alexisvieiro/ProyectoFinal/README.md

# Proyecto Final
  -Hardware y Software para un Hub de SNMP con sensores de temperatura y apertura de puertas, 
  realizado en Kicad y Visual Studio Code.
  
  -APP en android para la visualización de gráficas tomadas de la API de Zabbix.
