alexisvieiro/ProyectoFinal/Informes/Grupo 3 - Monitoreo Datacenter - Fotos y Videos - Proyecto Final.pdf

# Proyecto Final

“Monitoreo SNMP”

Fotos y Videos

Pruebas con el Cable del Sensor de Temperatura: Video

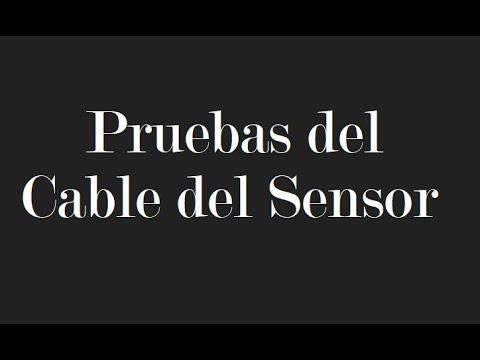
[picture p6: figure]

Vista 3D del Diseño en Proceso

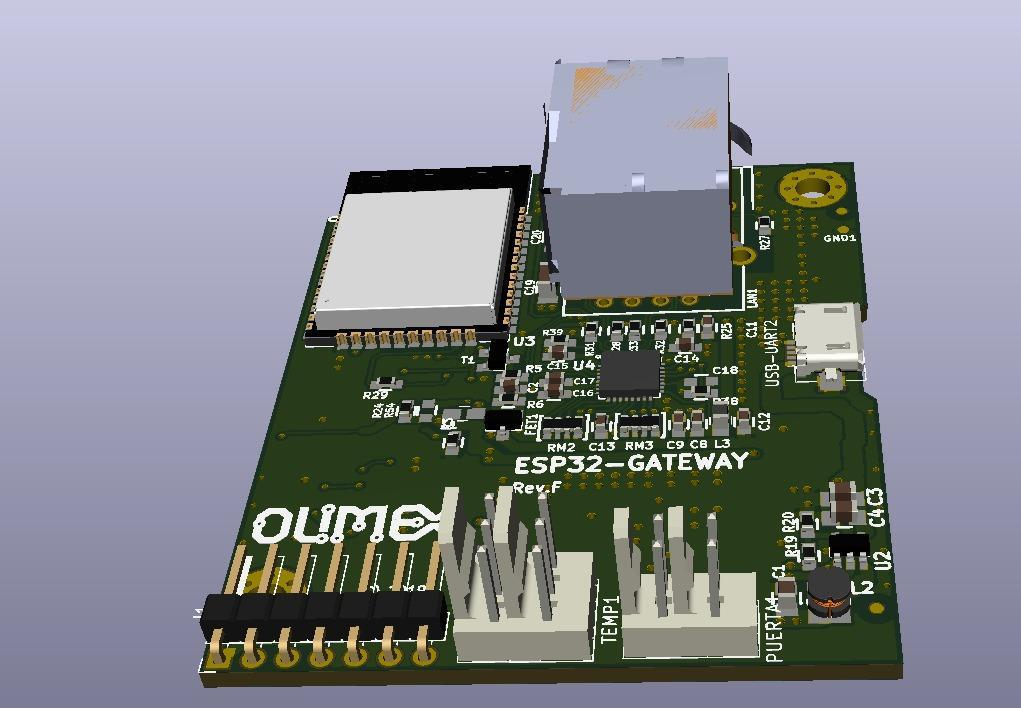
[picture p7: figure]

Vista 3D del Diseño Terminado

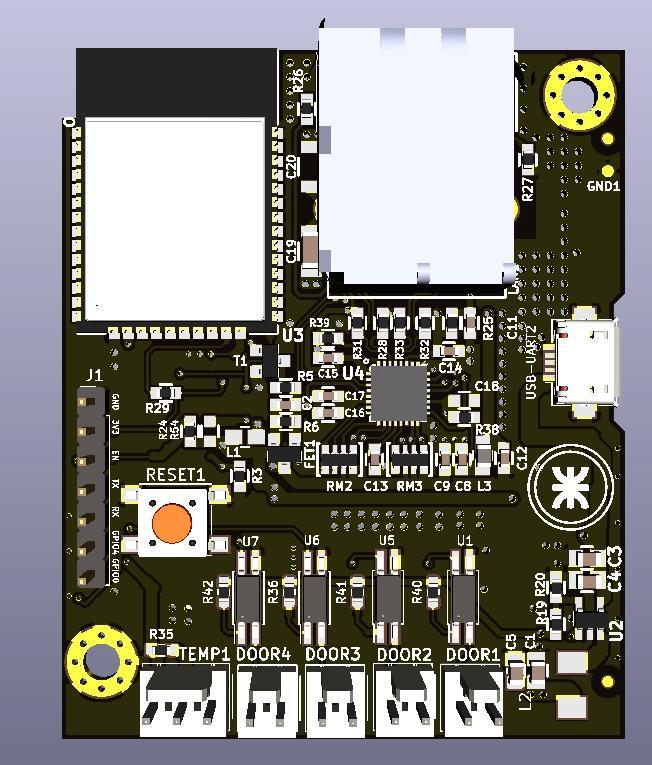
[picture p8: figure]

Llegaron las placas

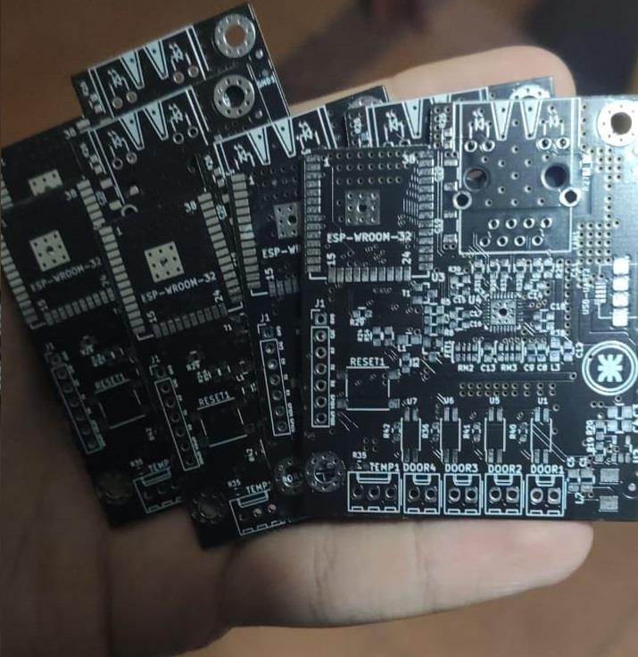
[picture p9: figure]

Placa en Proceso de Soldado

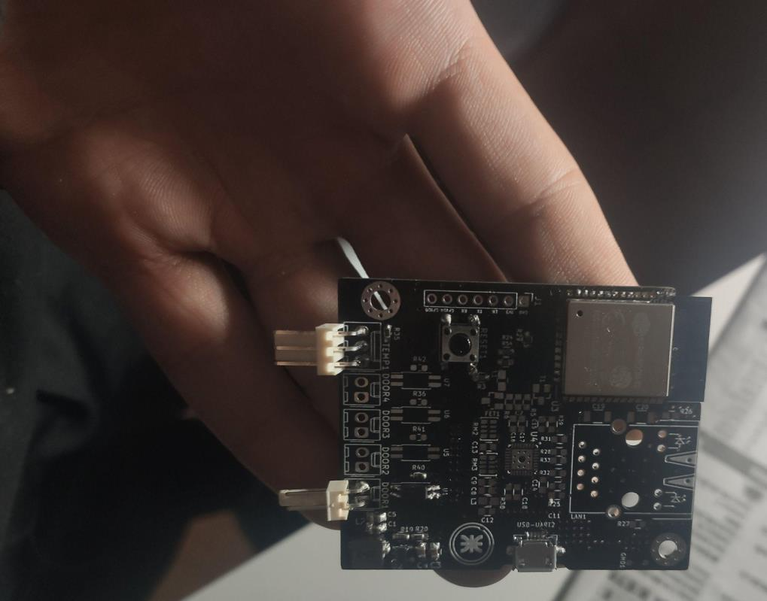
[picture p10: figure]

Primeras Pruebas

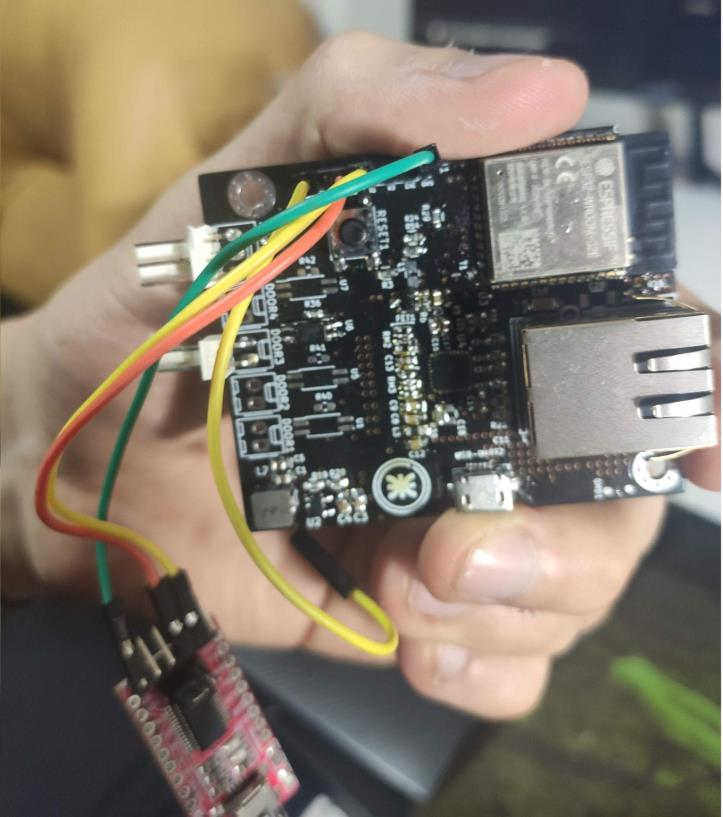
[picture p11: figure]

Primeras Pruebas SNMP: Video

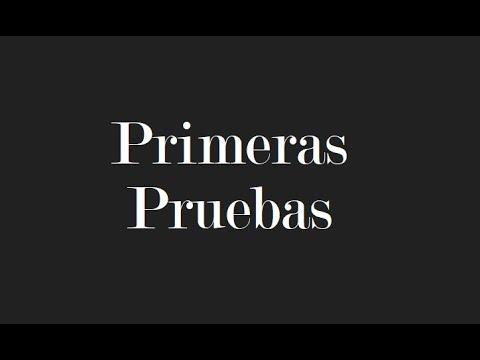
[picture p12: figure]

Placa Soldada Presentada en Carcasa

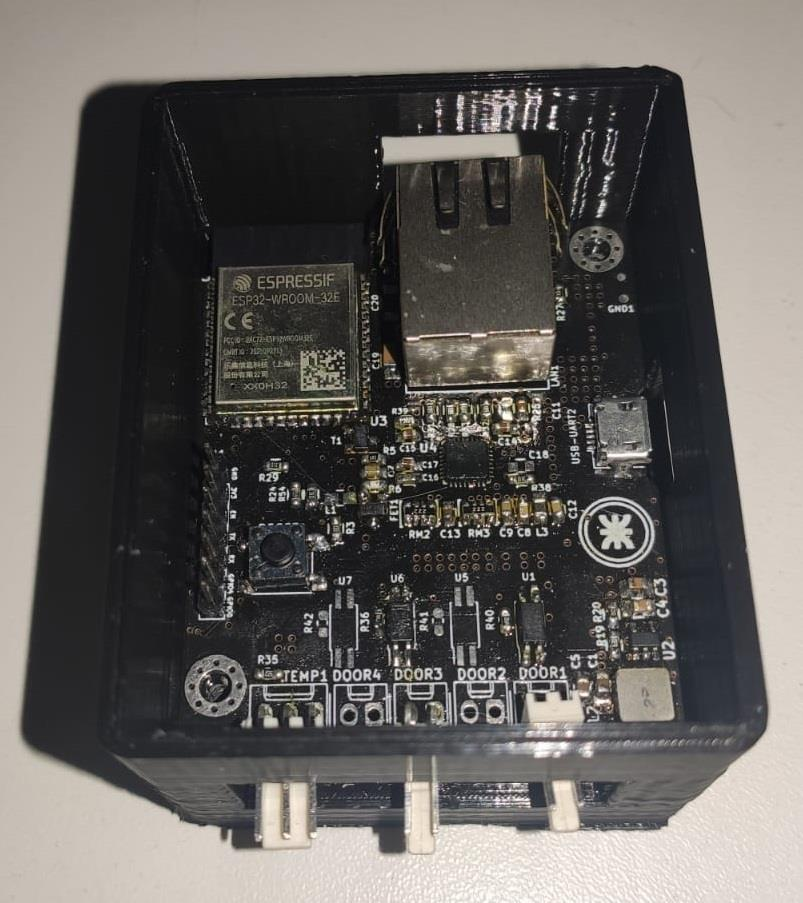
[picture p13: figure]

Placa Dentro de la Carcasa para Racks

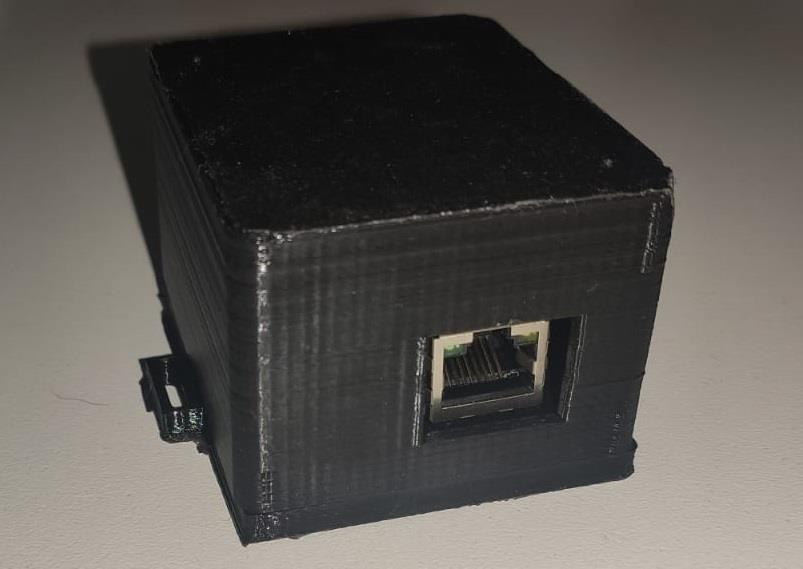
[picture p14: figure]

Pruebas Finales: Video

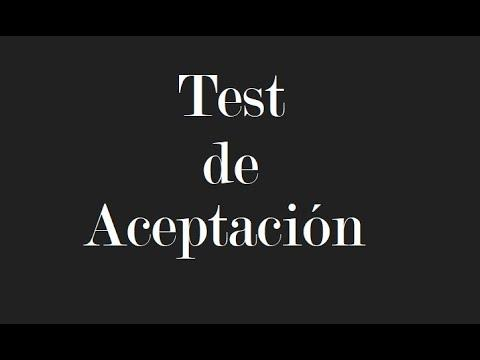
[picture p15: figure]

Aplicación Android

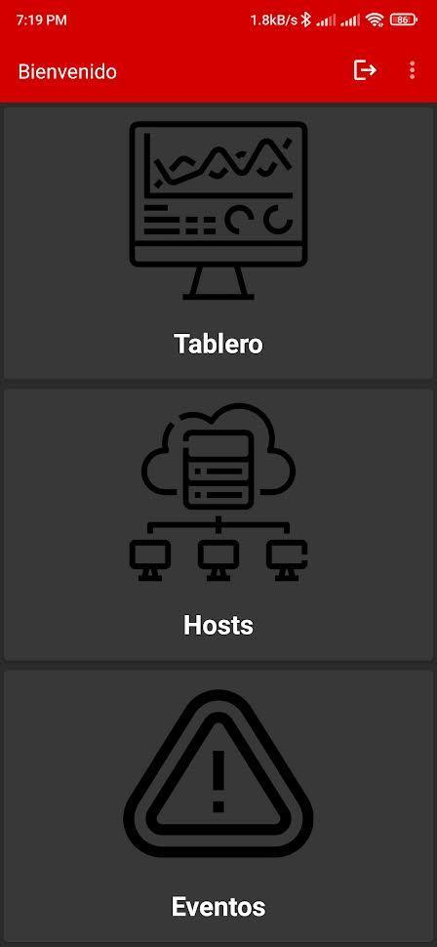
[picture p16: figure]

Gráfico de Aplicación Android en Horizontal

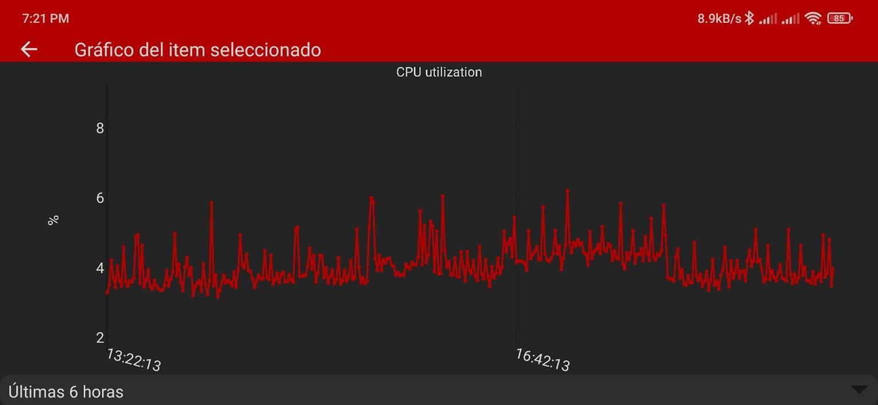
[picture p17: figure]

Zabbix Web visualizando Temperatura del Concentrador

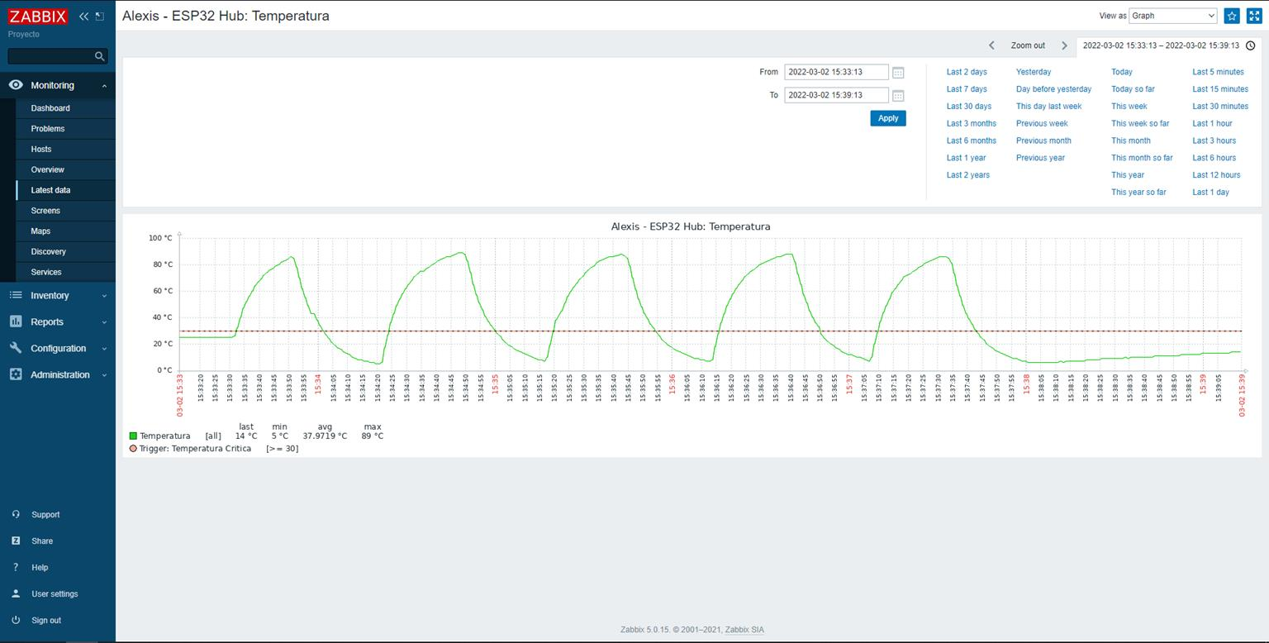
[picture p18: figure]
