alexisvieiro/ProyectoFinal/ConcentradorSNMP/Hardware/Carcasa-CarcasaTapa de la Carcasa.stl

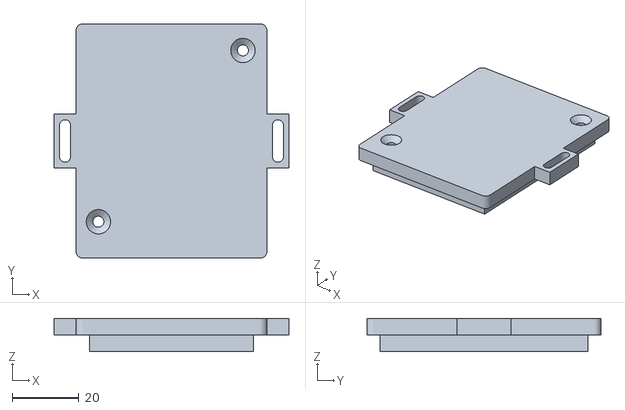
[picture p59: CAD file, 2022-03-20]
ConcentradorSNMP/Hardware/Carcasa-CarcasaTapa de la Carcasa.stl
70.2 x 70.0 x 10.0
