alexisvieiro/ProyectoFinal/ConcentradorSNMP/Hardware/3d/2pin-molex.stp

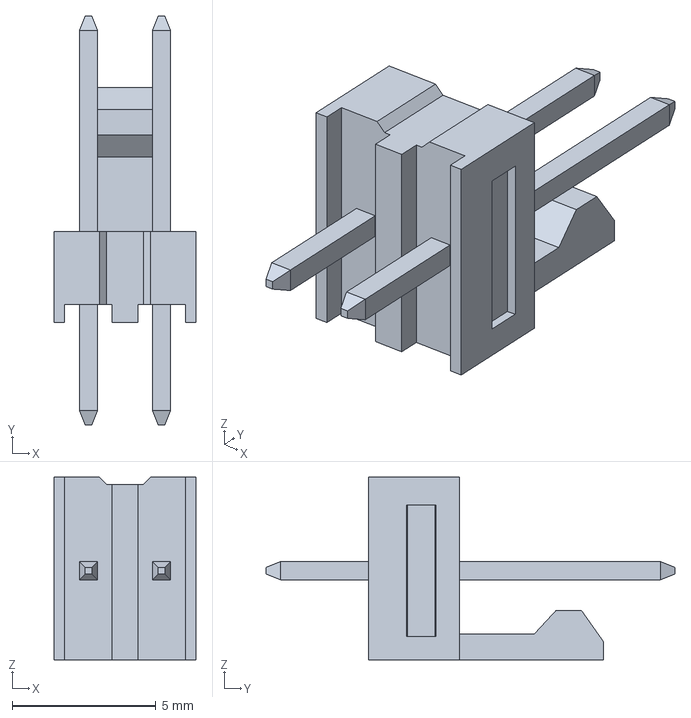
[picture p60: CAD file, 2021-08-22]
ConcentradorSNMP/Hardware/3d/2pin-molex.stp
4.93 x 14.2 x 6.35 mm
