alexisvieiro/ProyectoFinal/ConcentradorSNMP/Hardware/Carcasa-CarcasaBase de la Carcasa.stl

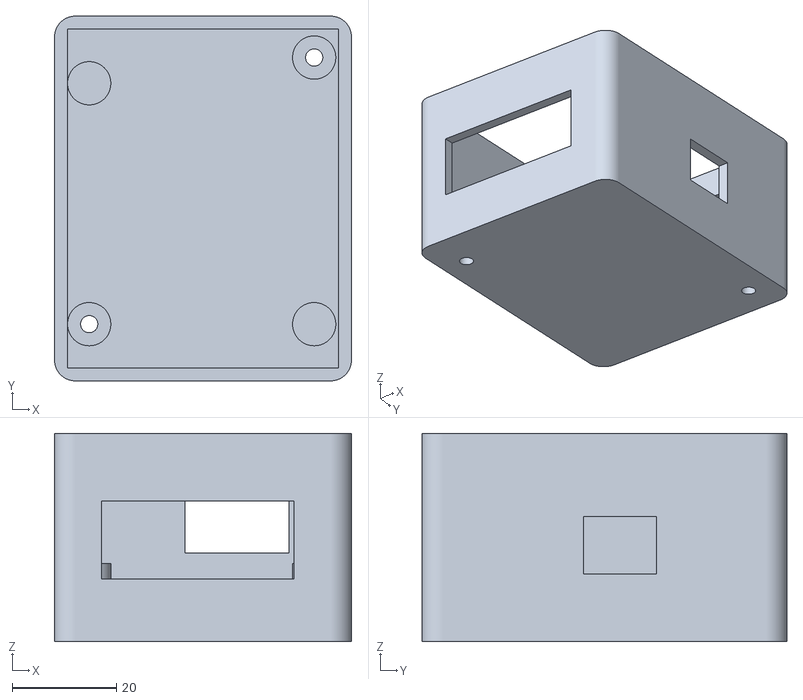
[picture p61: CAD file, 2022-03-20]
ConcentradorSNMP/Hardware/Carcasa-CarcasaBase de la Carcasa.stl
57.0 x 70.0 x 40.0
