alexisvieiro/ProyectoFinal/ConcentradorSNMP/Hardware/3d/SOT-23.step

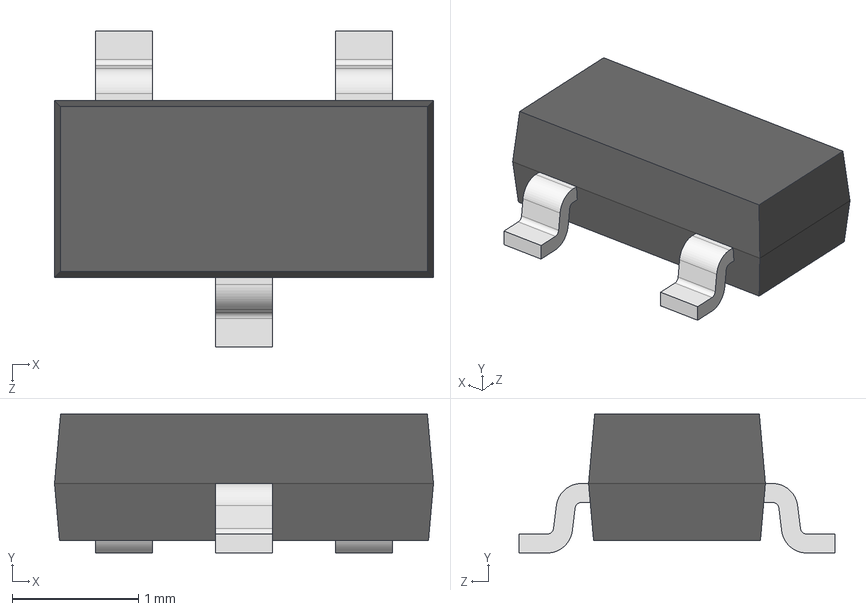
[picture p63: CAD file, 2021-07-10]
ConcentradorSNMP/Hardware/3d/SOT-23.step
3.00 x 1.10 x 2.50 mm
