alexisvieiro/ProyectoFinal/ConcentradorSNMP/Hardware/3d/SOD123.step

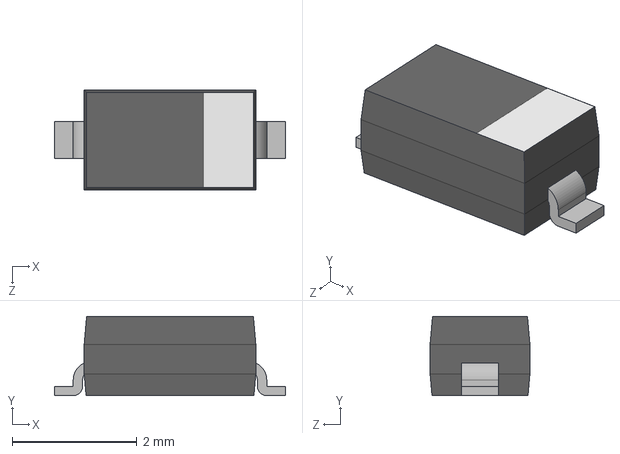
[picture p64: CAD file, 2021-07-10]
ConcentradorSNMP/Hardware/3d/SOD123.step
3.70 x 1.27 x 1.60 mm
