alexisvieiro/ProyectoFinal/ConcentradorSNMP/Hardware/3d/QFN32_5x5.step

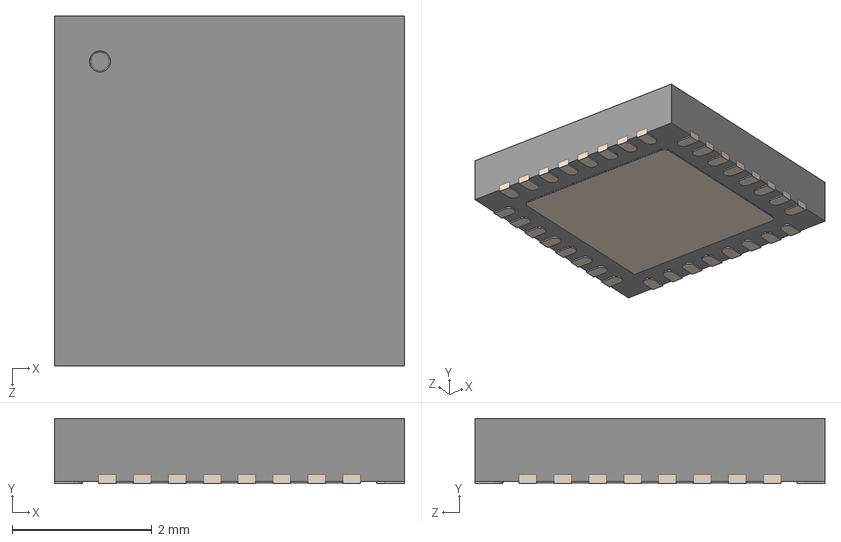
[picture p65: CAD file, 2021-07-10]
ConcentradorSNMP/Hardware/3d/QFN32_5x5.step
5.00 x 0.93 x 5.00 mm
