alexisvieiro/ProyectoFinal/ConcentradorSNMP/Hardware/3d/DO-214AC_SMA.step

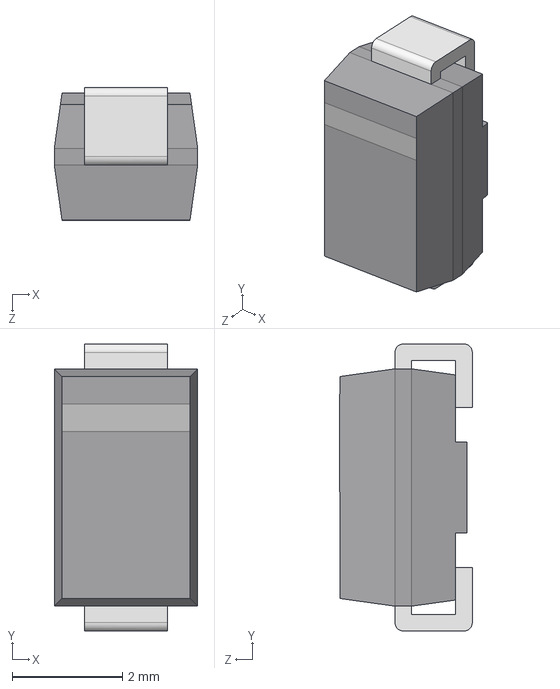
[picture p66: CAD file, 2021-07-10]
ConcentradorSNMP/Hardware/3d/DO-214AC_SMA.step
2.60 x 5.20 x 2.40 mm
