alexisvieiro/ProyectoFinal/ConcentradorSNMP/Hardware/3d/ESP32-WROOM-32D-56544.STEP

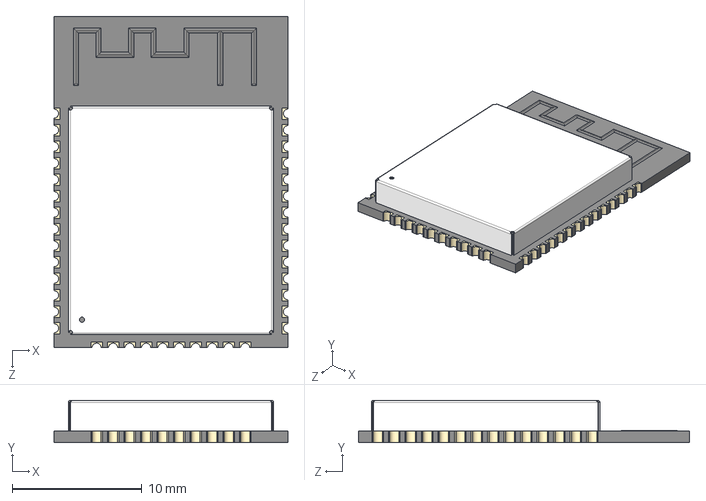
[picture p67: CAD file, 2021-07-10]
ConcentradorSNMP/Hardware/3d/ESP32-WROOM-32D-56544.STEP
18.0 x 3.25 x 25.5 mm
