alexisvieiro/ProyectoFinal/ConcentradorSNMP/Hardware/3d/esp-wroom-32.step

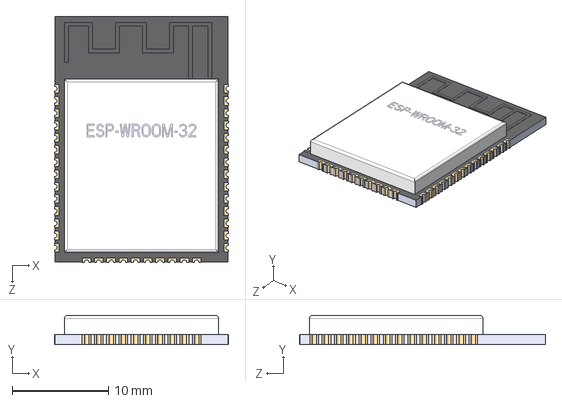
[picture p68: CAD file, 2021-07-10]
ConcentradorSNMP/Hardware/3d/esp-wroom-32.step
18.1 x 3.04 x 25.5 mm
