alexisvieiro/ProyectoFinal/ConcentradorSNMP/Hardware/3d/User_Library-Crystal_HC49_US-SM.step

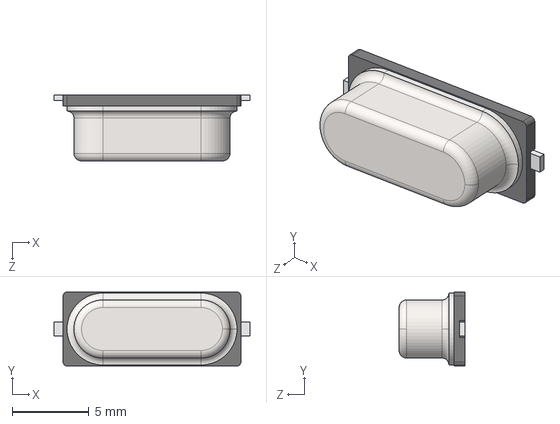
[picture p69: CAD file, 2021-07-10]
ConcentradorSNMP/Hardware/3d/User_Library-Crystal_HC49_US-SM.step
12.8 x 4.83 x 4.30 mm
