alexisvieiro/ProyectoFinal/ConcentradorSNMP/Hardware/3d/usb_micro_4p.stp

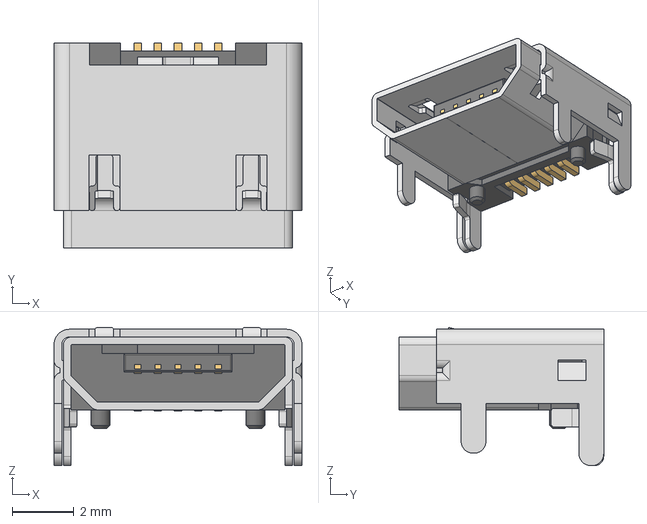
[picture p70: CAD file, 2021-07-10]
ConcentradorSNMP/Hardware/3d/usb_micro_4p.stp
8.00 x 6.60 x 4.46 mm
