alexisvieiro/ProyectoFinal/ConcentradorSNMP/Hardware/3d/BAT54.step

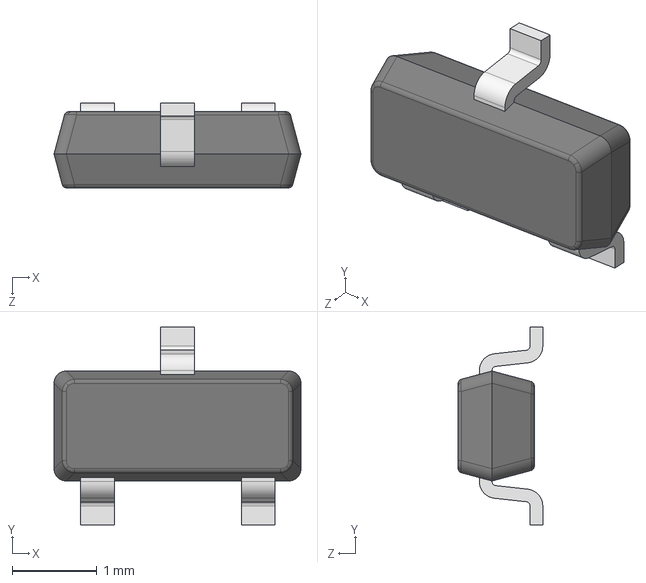
[picture p71: CAD file, 2021-07-10]
ConcentradorSNMP/Hardware/3d/BAT54.step
2.92 x 2.34 x 1.00 mm
