alexisvieiro/ProyectoFinal/ConcentradorSNMP/Hardware/3d/DO-214AA_SMB.step

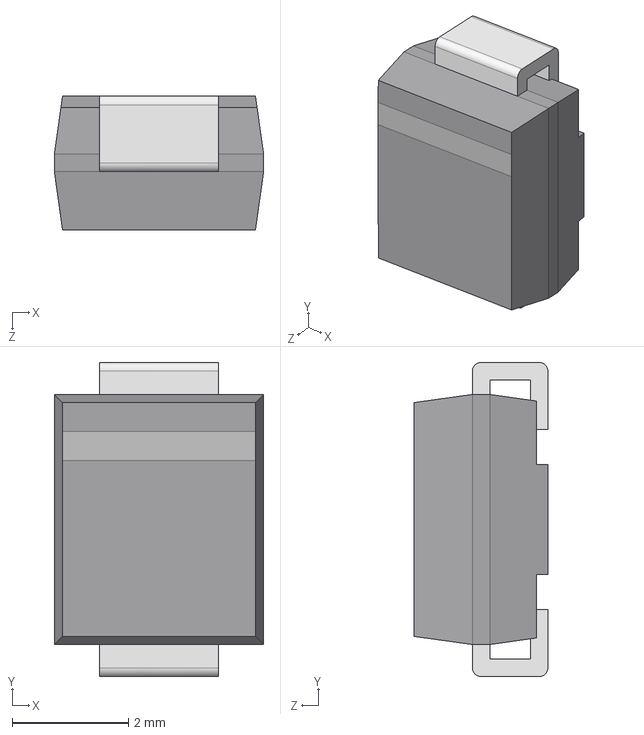
[picture p72: CAD file, 2021-07-10]
ConcentradorSNMP/Hardware/3d/DO-214AA_SMB.step
3.60 x 5.40 x 2.30 mm
