alexisvieiro/ProyectoFinal/ConcentradorSNMP/Hardware/3d/CD32_inductor.step

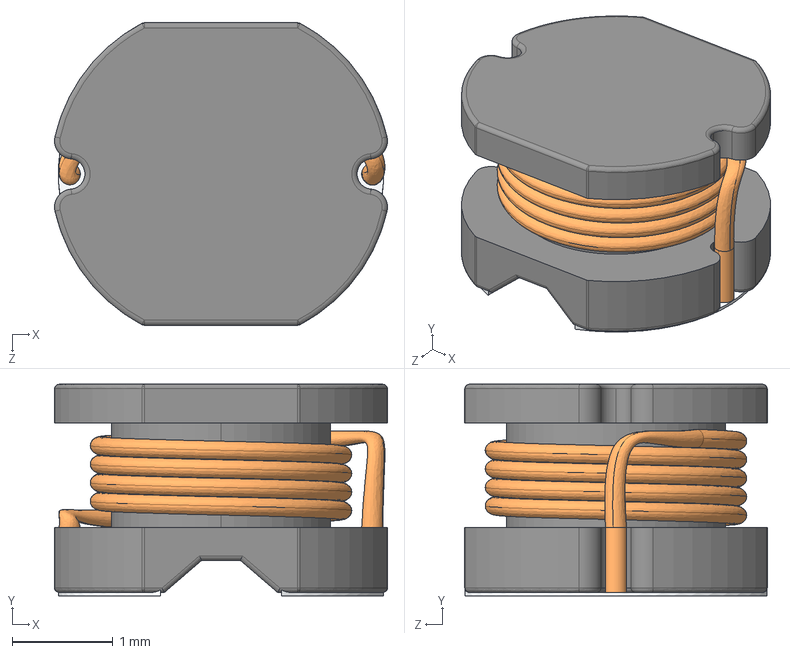
[picture p73: CAD file, 2021-07-10]
ConcentradorSNMP/Hardware/3d/CD32_inductor.step
3.30 x 2.10 x 3.00 mm
