alexisvieiro/ProyectoFinal/ConcentradorSNMP/Hardware/3d/10104110-0001LF.stp

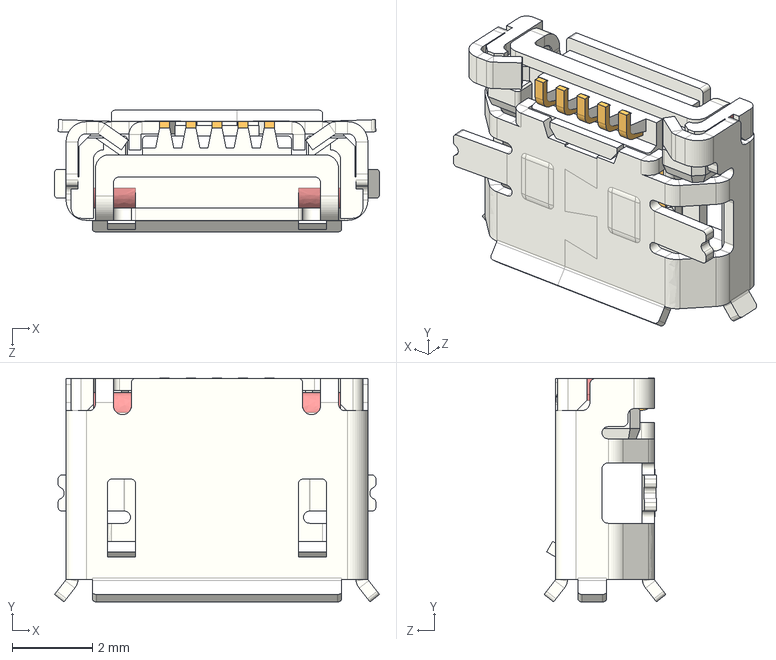
[picture p74: CAD file, 2021-08-22]
ConcentradorSNMP/Hardware/3d/10104110-0001LF.stp
8.08 x 5.56 x 3.03 mm
