alexisvieiro/ProyectoFinal/ConcentradorSNMP/Hardware/3d/434121043836 (rev1).stp

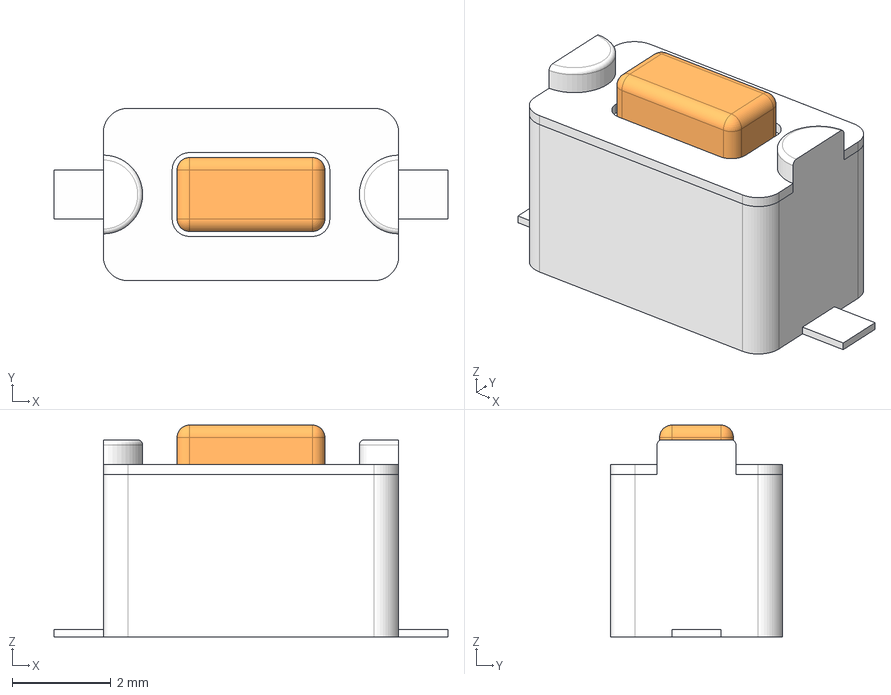
[picture p75: CAD file, 2021-07-10]
ConcentradorSNMP/Hardware/3d/434121043836 (rev1).stp
8.00 x 3.50 x 4.30 mm
Frame
Cover
pins x 2
