alexisvieiro/ProyectoFinal/(list of files, cad)

Other CAD files:
ConcentradorSNMP/Hardware/Carcasa.FCStd
ConcentradorSNMP/Hardware/3d/5040771891.stp
