alexisvieiro/ProyectoFinal/ConcentradorSNMP/Hardware/Gerbers Propios/HUB-SNMP-F_SilkS.pdf

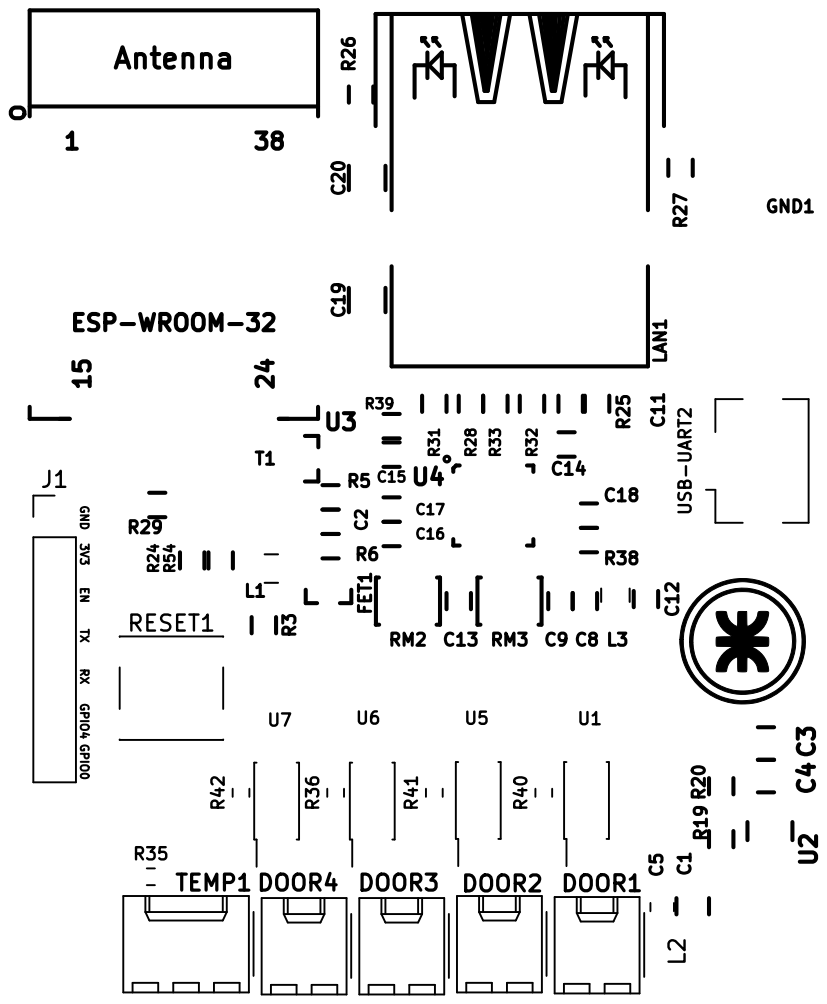
[picture p85: page 1]

GPIO0 GPIO4 RX TX EN 3V3 GND R42 DOOR4
