alexisvieiro/ProyectoFinal/ConcentradorSNMP/Hardware/HUB-SNMP_Esquematico.pdf

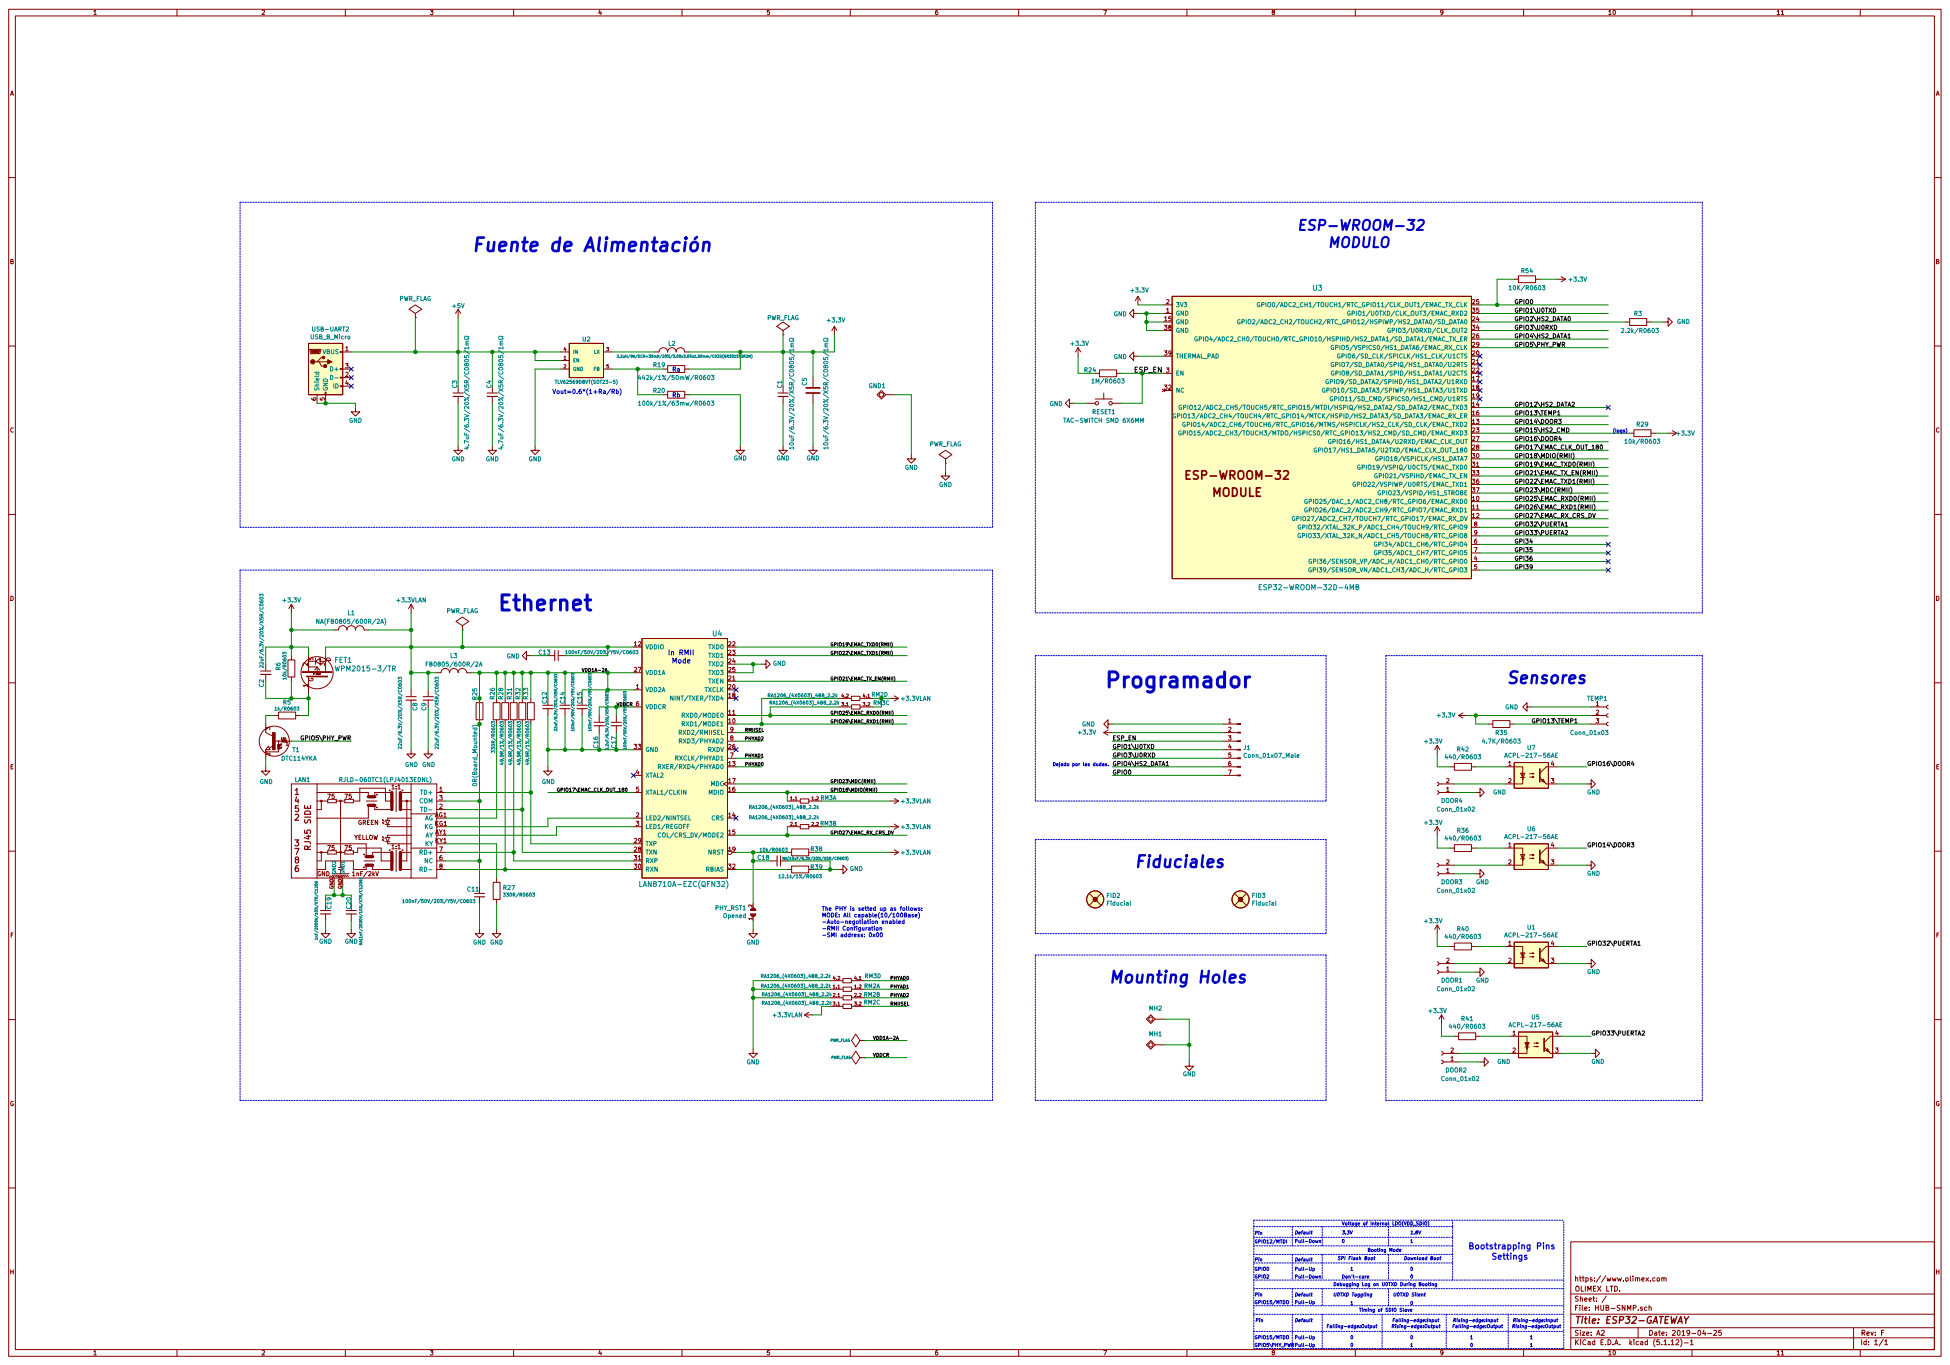
[picture p86: page 1]

0 Falling-edge:Input 1 Ethernet

Dejado por las dudas. The PHY is setted up as follows: MODE: All capable(10/100Base)

File: HUB-SNMP.sch Sheet: / OLIMEX LTD. https://www.olimex.com

0 Debugging Log on U0TXD During Booting
