alexisvieiro/ProyectoFinal/ConcentradorSNMP/Hardware/Gerbers Propios/HUB-SNMP-B_Cu.pdf

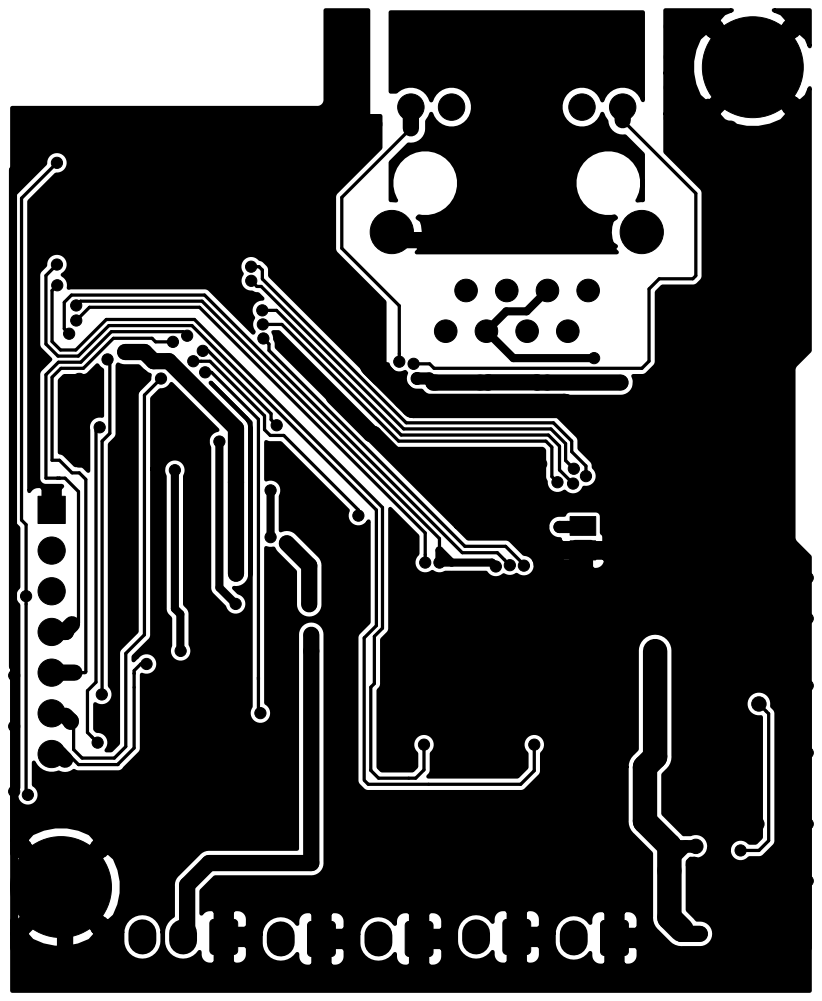
[picture p87: page 1]
