alexisvieiro/ProyectoFinal/ConcentradorSNMP/Hardware/Gerbers Propios/HUB-SNMP-B_Mask.pdf

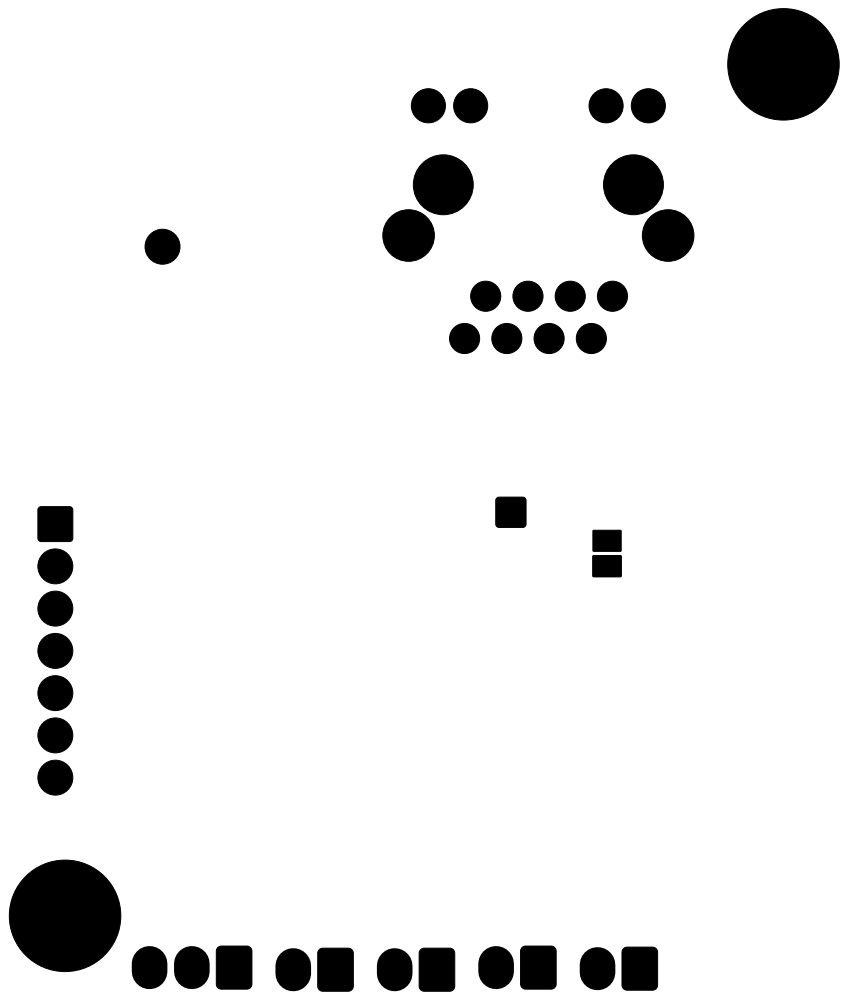
[picture p88: page 1]
