alexisvieiro/ProyectoFinal/ConcentradorSNMP/Hardware/Gerbers Propios/HUB-SNMP-B_SilkS.pdf

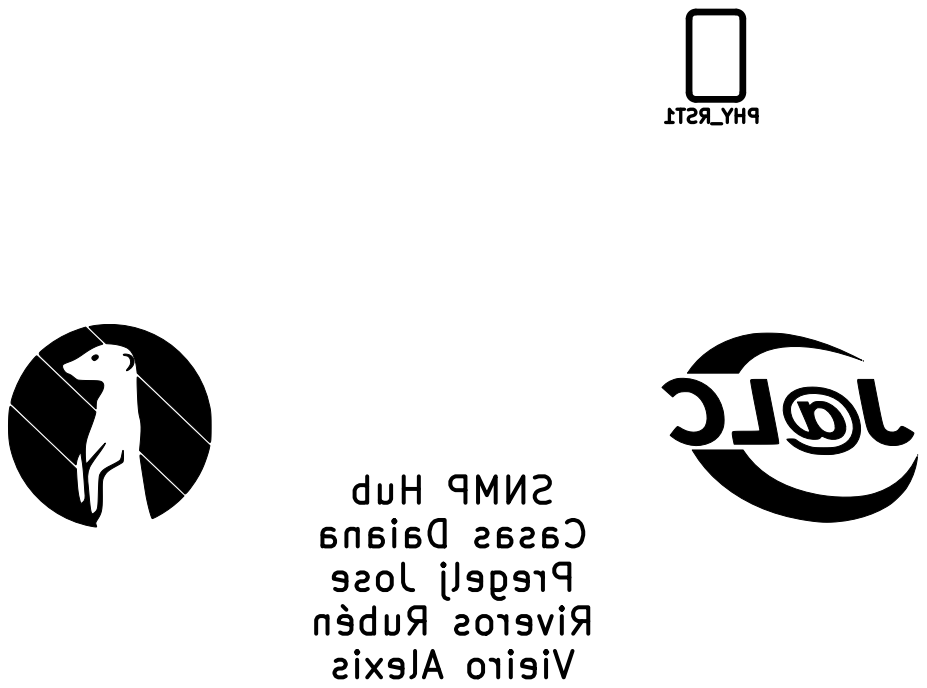
[picture p89: page 1]

SNMP Hub Casas Daiana Pregelj Jose Riveros Rubén Vieiro Alexis
