alexisvieiro/ProyectoFinal/ConcentradorSNMP/Hardware/Gerbers Propios/HUB-SNMP-Dwgs_User.pdf

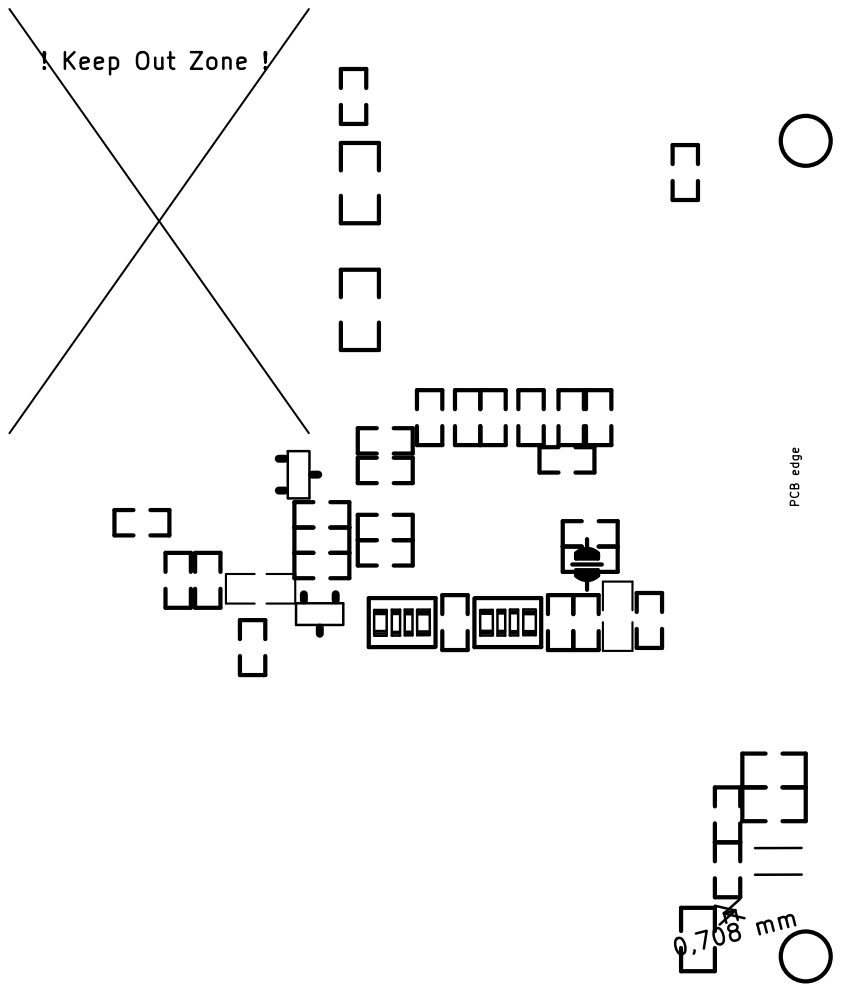
[picture p90: page 1]
