alexisvieiro/ProyectoFinal/ConcentradorSNMP/Hardware/Gerbers Propios/HUB-SNMP-F_CrtYd.pdf

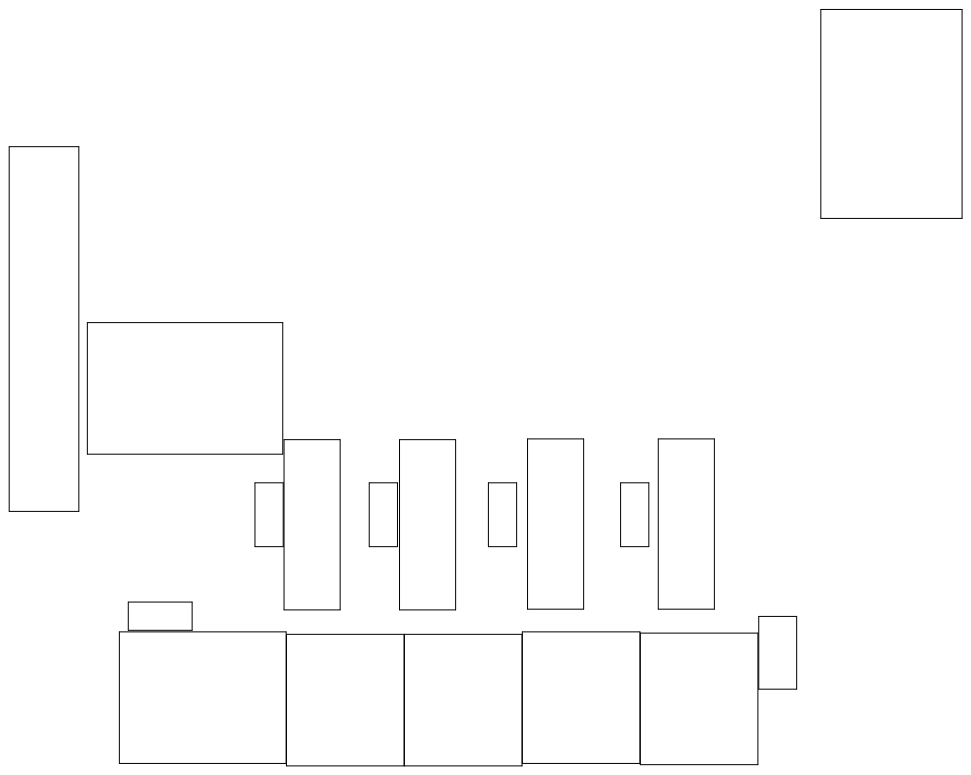
[picture p91: page 1]
