alexisvieiro/ProyectoFinal/ConcentradorSNMP/Hardware/HUB-SNMP.kicad_pcb

## KiCad design ConcentradorSNMP/Hardware/HUB-SNMP.kicad_pcb (2021-11-24)

Schematic: HUB-SNMP.sch, ESP32-GATEWAY

Parts:
C1: 10uF/6.3V/20%/X5R/C0805/1mΩ; C_0805_5MIL_DWS
C2, C8, C9, C12: 22uF/6.3V/20%/X5R/C0603; C_0603_5MIL_DWS
C3, C4: 4.7uF/6.3V/20%/X5R/C0805/1mΩ; C_0805_5MIL_DWS
C5: 10uF/6.3V/20%/X5R/C0805/1mΩ; C_0805_2012Metric_Pad1.18x1.45mm_HandSolder
C11, C13, C14, C15, C17: 100nF/50V/20%/Y5V/C0603; C_0603_5MIL_DWS
C16: 2.2uF/6.3V/10%/X5R/C0603; C_0603_5MIL_DWS
C18: NA(10uF/6.3V/20%/X5R/C0603); C_0603_5MIL_DWS
C19: 1nF/2000V/10%/X7R/C1206; C_1206_5MIL_DWS_ISO
C20: NA(1nF/2000V/10%/X7R/C1206); C_1206_5MIL_DWS_ISO
DOOR1, DOOR2, DOOR3, DOOR4: Conn_01x02; Molex_KK-254_AE-6410-02A_1x02_P2.54mm_Vertical
FET1: WPM2015-3/TR; SOT23
FID2, FID3: Fiducial; Fiducial1x3
GND1: TESTPAD; TESTPAD_40-ROUND
J1: Conn_01x07_Male; PinHeader_1x07_P2.54mm_Vertical
L1: NA(FB0805/600R/2A); L_0805_5MIL_DWS
L2: 2.2uH/9A/DCR=35mR/20%/3.00x3.00x1.50mm/CD32(NR301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; SMD_0530
L3: FB0805/600R/2A; L_0805_5MIL_DWS
LAN1: RJLD-060TC1(LPJ4013EDNL); RJLBC-060TC1
MH1, MH2: Mounting_hole_Shield_3.3mm
PHY_RST1: Opened; SJ
R3: 2.2k/R0603; R_0603_5MIL_DWS
R5: 1k/R0603; R_0603_5MIL_DWS
R6, R29, R38: 10k/R0603; R_0603_5MIL_DWS
R19: 442k/1%/50mW/R0603; R_0603_5MIL_DWS
R20: 100k/1%/63mw/R0603; R_0603_5MIL_DWS
R24: 1M/R0603; R_0603_5MIL_DWS
R25: 0R(Board_Mounted); R_0603_5MIL_DWS
R26, R27: 330R/R0603; R_0603_5MIL_DWS
R28, R31, R32, R33: 49.9R/1%/R0603; R_0603_5MIL_DWS
R35: 4.7K/R0603; R_0603_1608Metric_Pad0.98x0.95mm_HandSolder
R36, R40, R41, R42: 440/R0603; R_0603_1608Metric_Pad0.98x0.95mm_HandSolder
R39: 12.1k/1%/R0603; R_0603_5MIL_DWS
R54: 10K/R0603; R_0603_5MIL_DWS
RESET1: TAC-SWITCH SMD 6X6MM; SW_SPST_PTS645
RM2, RM3: RA1206_(4X0603)_4B8_2.2k; R_MATRIX_4
T1: DTC114YKA; SOT23
TEMP1: Conn_01x03; Molex_KK-254_AE-6410-03A_1x03_P2.54mm_Vertical
U1, U5, U6, U7: ACPL-217-56AE; SO-4_4.4x2.3mm_P1.27mm
U2: TLV62569DBVT(SOT23-5); SOT-23-5
U3: ESP32-WROOM-32D-4MB; ESP-WROOM-32_MODULE
U4: LAN8710A-EZC(QFN32); QFN32_EP(33)_5.00x5.00x0.90mm_Pitch_0.50mm
USB-UART2: USB_B_Micro; USB_Micro-B_Amphenol_10104110_Horizontal

Connections:
+3.3VLAN: C8.1, C9.1, C13.1, FET1.3, L1.2, L3.1, R38.2, RM2.3.1, RM2.4.1, RM3.1.2, RM3.2.2, RM3.3.2, U4.12 (VDDIO)
+3V3: C1.1, C2.1, C5.1, FET1.2, J1.2, L1.1, L2.2, R6.1, R19.2, R24.1, R29.1, R35.2, R36.2, R40.2, R41.2, R42.2, R54.2, TEMP1.2, U3.2 (3V3)
+5V: C3.1, C4.1, U2.1 (EN), U2.4 (IN), USB-UART2.1 (VBUS)
/ESP_EN: J1.3, R24.2, RESET1.2, U3.3 (EN)
/GPI34: U3.6 (GPI34/ADC1_CH6/RTC_GPIO4)
/GPI35: U3.7 (GPI35/ADC1_CH7/RTC_GPIO5)
/GPI36: U3.4 (GPI36/SENSOR_VP/ADC_H/ADC1_CH0/RTC_GPIO0)
/GPI39: U3.5 (GPI39/SENSOR_VN/ADC1_CH3/ADC_H/RTC_GPIO3)
/GPIO0: J1.7, R54.1, U3.25 (GPIO0/ADC2_CH1/TOUCH1/RTC_GPIO11/CLK_OU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)
/GPIO1\U0TXD: J1.4, U3.35 (GPIO1/U0TXD/CLK_OUT3/EMAC_RXD2)
/GPIO2\HS2_DATA0: R3.2, U3.24 (GPIO2/ADC2_CH2/TOUCH2/RTC_GPIO12/HSPIWP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)
/GPIO3\U0RXD: J1.5, U3.34 (GPIO3/U0RXD/CLK_OUT2)
/GPIO4\HS2_DATA1: J1.6, U3.26 (GPIO4/ADC2_CH0/TOUCH0/RTC_GPIO10/HSPIHD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)
/GPIO5\PHY_PWR: T1.1 (B), U3.29 (GPIO5/VSPICS0/HS1_DATA6/EMAC_RX_CLK)
/GPIO12\HS2_DATA2: U3.14 (GPIO12/ADC2_CH5/TOUCH5/RTC_GPIO15/MTDI/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)
/GPIO13\TEMP1: R35.1, TEMP1.3, U3.16 (GPIO13/ADC2_CH4/TOUCH4/RTC_GPIO14/MTCK/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)
/GPIO14\DOOR3: U3.13 (GPIO14/ADC2_CH6/TOUCH6/RTC_GPIO16/MTMS/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), U6.4
/GPIO15\HS2_CMD: R29.2, U3.23 (GPIO15/ADC2_CH3/TOUCH3/MTDO/HSPICS0/RTC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)
/GPIO16\DOOR4: U3.27 (GPIO16/HS1_DATA4/U2RXD/EMAC_CLK_OUT), U7.4
/GPIO17\EMAC_CLK_OUT_180: U3.28 (GPIO17/HS1_DATA5/U2TXD/EMAC_CLK_OUT_180), U4.5 (XTAL1/CLKIN)
/GPIO18\MDIO(RMII): RM3.1.1, U3.30 (GPIO18/VSPICLK/HS1_DATA7), U4.16 (MDIO)
/GPIO19\EMAC_TXD0(RMII): U3.31 (GPIO19/VSPIQ/U0CTS/EMAC_TXD0), U4.22 (TXD0)
/GPIO21\EMAC_TX_EN(RMII): U3.33 (GPIO21/VSPIHD/EMAC_TX_EN), U4.21 (TXEN)
/GPIO22\EMAC_TXD1(RMII): U3.36 (GPIO22/VSPIWP/U0RTS/EMAC_TXD1), U4.23 (TXD1)
/GPIO23\MDC(RMII): U3.37 (GPIO23/VSPID/HS1_STROBE), U4.17 (MDC)
/GPIO25\EMAC_RXD0(RMII): RM3.3.1, U3.10 (GPIO25/DAC_1/ADC2_CH8/RTC_GPIO6/EMAC_RX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), U4.11 (RXD0/MODE0)
/GPIO26\EMAC_RXD1(RMII): RM2.4.2, U3.11 (GPIO26/DAC_2/ADC2_CH9/RTC_GPIO7/EMAC_RX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), U4.10 (RXD1/MODE1)
/GPIO27\EMAC_RX_CRS_DV: RM3.2.1, U3.12 (GPIO27/ADC2_CH7/TOUCH7/RTC_GPIO17/EMAC_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), U4.15 (COL/CRS_DV/MODE2)
/GPIO32\PUERTA1: U1.4, U3.8 (GPIO32/XTAL_32K_P/ADC1_CH4/TOUCH9/RTC_G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)
/GPIO33\PUERTA2: U3.9 (GPIO33/XTAL_32K_N/ADC1_CH5/TOUCH8/RTC_G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), U5.4
/PHYAD0: RM3.4.1, U4.13 (RXER/RXD4/PHYAD0)
/PHYAD1: RM2.1.2, U4.7 (RXCLK/PHYAD1)
/PHYAD2: RM2.2.2, U4.8 (RXD3/PHYAD2)
/RMIISEL: RM2.3.2, U4.9 (RXD2/RMIISEL)
/VDD1A-2A: C11.1, C12.1, C14.1, C15.1, L3.2, LAN1.3 (COM), LAN1.6 (NC), R25.1, R25.2, R26.1, R28.1, R31.1, R32.1, R33.1, U4.1 (VDD2A), U4.27 (VDD1A)
/VDDCR: C16.1, C17.1, U4.6 (VDDCR)
GND: C1.2, C3.2, C4.2, C5.2, C8.2, C9.2, C11.2, C12.2, C13.2, C14.2, C15.2, C16.2, C17.2, C18.1, C19.2, C20.2, DOOR1.1, DOOR2.1, DOOR3.1, DOOR4.1, GND1.1, J1.1, MH1.GND1, MH2.GND1, PHY_RST1.1, R3.1, R20.2, R27.2, R39.2, RESET1.1, RM2.1.1, RM2.2.1, RM3.4.2, T1.2 (E), TEMP1.1, U1.3, U2.2 (GND), U3.1 (GND), U3.15 (GND), U3.38 (GND), U3.39 (THERMAL_PAD), U4.24 (TXD2), U4.25 (TXD3), U4.33 (GND), U5.3, U6.3, U7.3, USB-UART2.5 (GND), USB-UART2.6 (Shield)
unnamed: C2.2, FET1.1, R5.1, R6.2
unnamed: C18.2, PHY_RST1.2, R38.1, U4.19 (NRST)
unnamed: C19.1, C20.1, LAN1.GND1, LAN1.GND2
unnamed: DOOR1.2, U1.2
unnamed: DOOR2.2, U5.2
unnamed: DOOR3.2, U6.2
unnamed: DOOR4.2, U7.2
unnamed: L2.1, U2.3 (LX)
unnamed: LAN1.1 (TD+), R33.2, U4.29 (TXP)
unnamed: LAN1.2 (TD-), R32.2, U4.28 (TXN)
unnamed: LAN1.7 (RD+), R31.2, U4.31 (RXP)
unnamed: LAN1.8 (RD-), R28.2, U4.30 (RXN)
unnamed: LAN1.AG1 (AG), R26.2
unnamed: LAN1.AY1 (AY), U4.3 (LED1/REGOFF)
unnamed: LAN1.KG1 (KG), U4.2 (LED2/NINTSEL)
unnamed: LAN1.KY1 (KY), R27.1
unnamed: R5.2, T1.3 (C)
unnamed: R19.1, R20.1, U2.5 (FB)
unnamed: R36.1, U6.1
unnamed: R39.1, U4.32 (RBIAS)
unnamed: R40.1, U1.1
unnamed: R41.1, U5.1
unnamed: R42.1, U7.1

Notes on the sheet:
Vout=0.6*(1+Ra/Rb)
Fuente de Alimentación
In RMII Mode
Ethernet
ESP-WROOM-32 MODULO
Bootstrapping Pins Settings
Voltage of Internal LDO(VDD_SDIO)
Pin
Default
3.3V
1.8V
Booting Mode
GPIO12/MTDI
Pull-Down
GPIO0
GPIO2
Pull-Up
SPI Flash Boot
Download Boot
Don't-care
Debugging Log on U0TXD During Booting
U0TXD Toggling
U0TXD Silent
GPIO15/MTDO
Timing of SDIO Slave
Falling-edge:Output
Falling-edge:Input
Rising-edge:Output
Rising-edge:Input
GPIO5\PHY_PWR
Sensores
The PHY is setted up as follows: MODE: All capable(10/100Base) -Auto-negotiation enabled -RMII Configuration -SMI address: 0x00
Programador
Mounting Holes
Fiduciales
(logs)
GPIO5\PHY_PWR:
MTDO/GPIO15:
GPIO4:
GPIO2:
GPIO0:
MTDI/GPIO12:
Internal Bootstrapping Resistors
Dejado por las dudas.

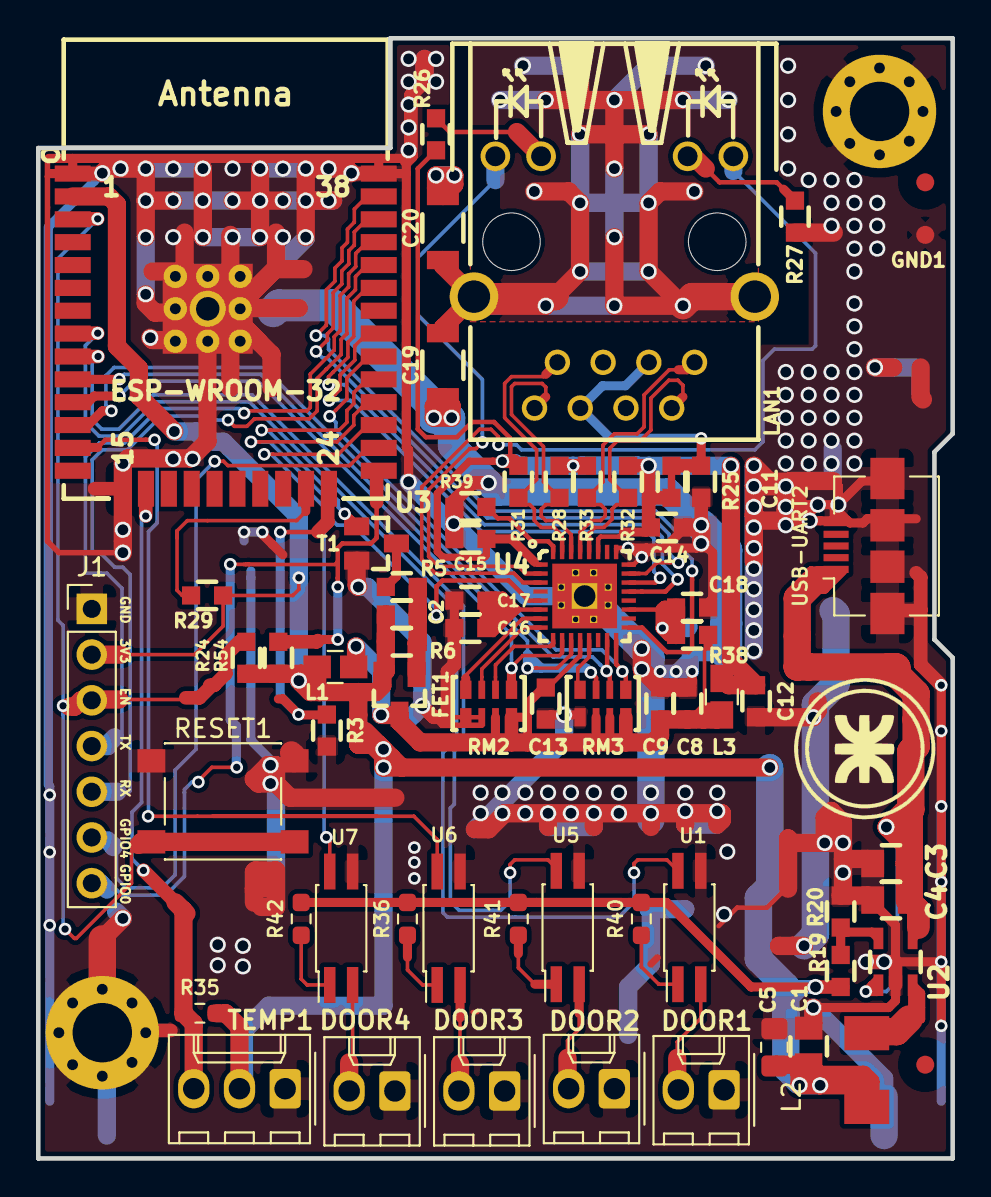
[picture p96: board HUB-SNMP.kicad_pcb from above]

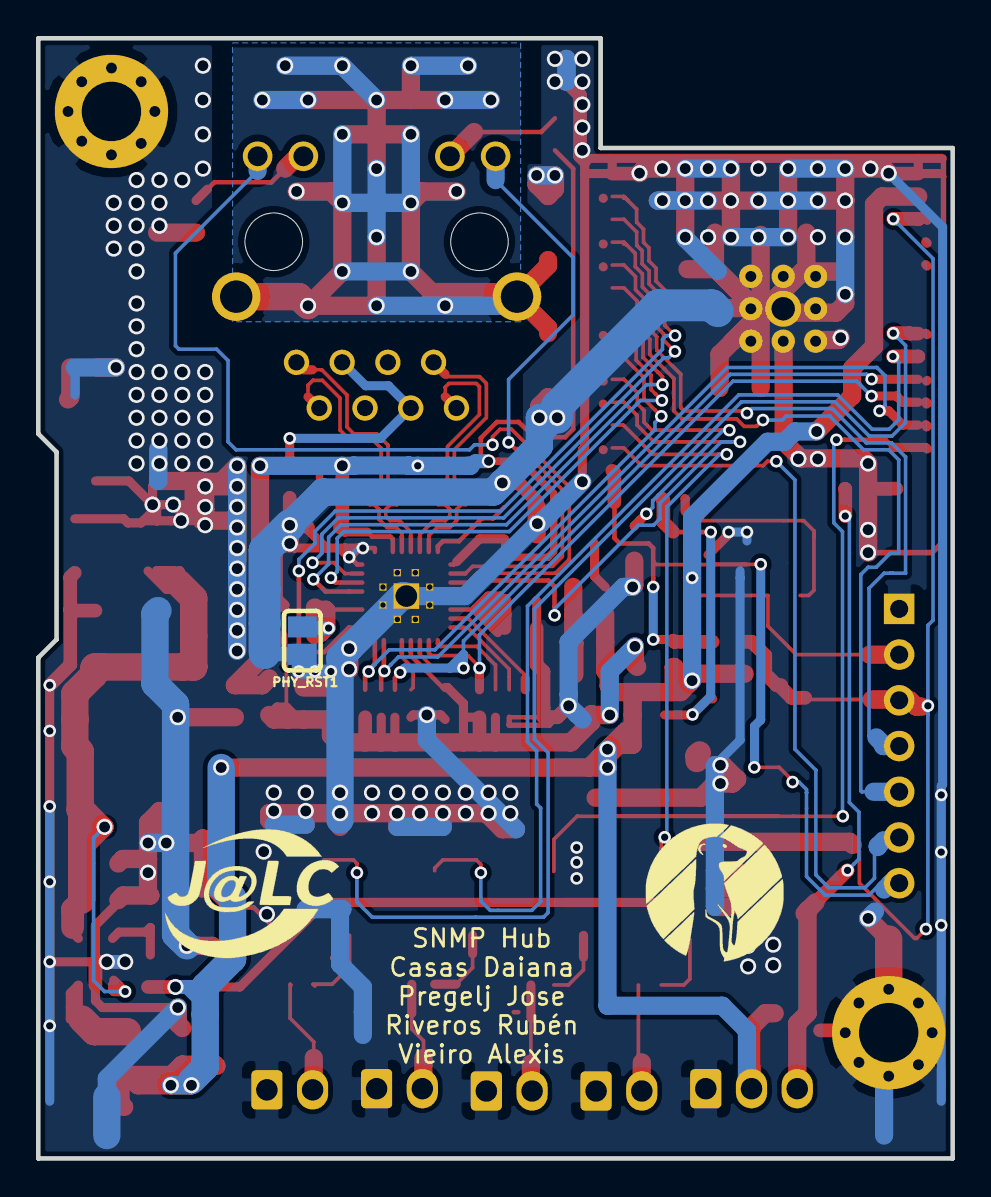
[picture p97: board HUB-SNMP.kicad_pcb from below]

Board: 2 copper layers, 50.8 x 62.2 mm, 70 parts (3 on the bottom side), 55 nets.

Other parts of the board:
G2: LOGO JLCPCB; jlcpcb_logo
G3: LOGO ERICNET; ericnet_logo
