alexisvieiro/ProyectoFinal/ConcentradorSNMP/Software/include/Sensors.h

#ifndef ABIERTA
#define ABIERTA 1
#define CERRADA 0
#endif
#define PinPuerta1 32
#define PinPuerta2 33
#define PinPuerta3 4
#define PinPuerta4 0
#define oneWireBus 13
void SensorsInit();
void SensadoPuertas();
void SensadoTemperatura();
void SensadoInterno();
