alexisvieiro/ProyectoFinal/ConcentradorSNMP/Software/include/MIB.h

#ifndef _MIB_H_
#define _MIB_H_

//
// tkmib - linux mib browser
//
// RFC1213-MIB OIDs
// .iso (.1)
// .iso.org (.1.3)
// .iso.org.dod (.1.3.6)
// .iso.org.dod.internet (.1.3.6.1)
// .iso.org.dod.internet.mgmt (.1.3.6.1.2)
// .iso.org.dod.internet.mgmt.mib-2 (.1.3.6.1.2.1)
// .iso.org.dod.internet.mgmt.mib-2.system (.1.3.6.1.2.1.1)
// .iso.org.dod.internet.mgmt.mib-2.system.sysDescr (.1.3.6.1.2.1.1.1)
const char sysDescr[] PROGMEM = "1.3.6.1.2.1.1.1.0"; // read-only  (DisplayString)
// .iso.org.dod.internet.mgmt.mib-2.system.sysObjectID (.1.3.6.1.2.1.1.2)
const char sysObjectID[] PROGMEM = "1.3.6.1.2.1.1.2.0"; // read-only  (ObjectIdentifier)
// .iso.org.dod.internet.mgmt.mib-2.system.sysUpTime (.1.3.6.1.2.1.1.3)
const char sysUpTime[] PROGMEM = "1.3.6.1.2.1.1.3.0"; // read-only  (TimeTicks)
// .iso.org.dod.internet.mgmt.mib-2.system.sysContact (.1.3.6.1.2.1.1.4)
const char sysContact[] PROGMEM = "1.3.6.1.2.1.1.4.0"; // read-write (DisplayString)
// .iso.org.dod.internet.mgmt.mib-2.system.sysName (.1.3.6.1.2.1.1.5)
const char sysName[] PROGMEM = "1.3.6.1.2.1.1.5.0"; // read-write (DisplayString)
// .iso.org.dod.internet.mgmt.mib-2.system.sysLocation (.1.3.6.1.2.1.1.6)
const char sysLocation[] PROGMEM = "1.3.6.1.2.1.1.6.0"; // read-write (DisplayString)
// .iso.org.dod.internet.mgmt.mib-2.system.sysServices (.1.3.6.1.2.1.1.7)
const char sysServices[] PROGMEM = "1.3.6.1.2.1.1.7.0"; // read-only  (Integer)
//
// Arduino defined OIDs
// .iso.org.dod.internet.private (.1.3.6.1.4)
// .iso.org.dod.internet.private.enterprises (.1.3.6.1.4.1)
// .iso.org.dod.internet.private.enterprises.arduino (.1.3.6.1.4.1.36582)
const char esp32Temperature1[] PROGMEM = "1.3.6.1.4.1.36582.0"; // read-only  (Integer)
const char esp32FreeHeap[] PROGMEM = "1.3.6.1.4.1.36582.1"; // read-only  (Integer)
const char esp32Door1[] PROGMEM = "1.3.6.1.4.1.36582.2"; // read-only  (Integer)
const char esp32Door2[] PROGMEM = "1.3.6.1.4.1.36582.3"; // read-only  (Integer)
const char esp32Door3[] PROGMEM = "1.3.6.1.4.1.36582.4"; // read-only  (Integer)
const char esp32Door4[] PROGMEM = "1.3.6.1.4.1.36582.5"; // read-only  (Integer)
const char esp32TemperatureLimit[] PROGMEM = "1.3.6.1.4.1.36582.6"; // read-write (DisplayString)
//
//        
#endif
