alexisvieiro/ProyectoFinal/ZabbixMobileApp/app/src/main/java/com/example/zabbixMobileApp/Fragments/DashboardItemFragment.java

package com.example.zabbixMobileApp.Fragments;

import android.content.Context;
import android.content.SharedPreferences;
import android.os.Build;
import android.os.Bundle;

import androidx.annotation.NonNull;
import androidx.annotation.Nullable;
import androidx.annotation.RequiresApi;
import androidx.appcompat.app.AppCompatDelegate;
import androidx.appcompat.widget.Toolbar;
import androidx.fragment.app.Fragment;

import android.os.Handler;
import android.os.Looper;
import android.util.Log;
import android.view.Gravity;
import android.view.LayoutInflater;
import android.view.View;
import android.view.ViewGroup;
import android.widget.AdapterView;
import android.widget.Toast;

import com.example.zabbixMobileApp.R;
import com.google.android.material.snackbar.Snackbar;
import com.jjoe64.graphview.GraphView;
import com.jjoe64.graphview.helper.StaticLabelsFormatter;
import com.jjoe64.graphview.series.DataPoint;
import com.jjoe64.graphview.series.DataPointInterface;
import com.jjoe64.graphview.series.LineGraphSeries;
import com.jjoe64.graphview.series.OnDataPointTapListener;
import com.jjoe64.graphview.series.Series;
import com.toptoche.searchablespinnerlibrary.SearchableSpinner;

import org.json.JSONArray;
import org.json.JSONException;
import org.json.JSONObject;

import java.io.IOException;
import java.text.SimpleDateFormat;
import java.util.ArrayList;
import java.util.Calendar;
import java.util.Collections;
import java.util.Date;
import java.util.List;

import okhttp3.Call;
import okhttp3.Callback;
import okhttp3.MediaType;
import okhttp3.OkHttpClient;
import okhttp3.Request;
import okhttp3.RequestBody;
import okhttp3.Response;


public class DashboardItemFragment extends Fragment {
    private Toolbar toolbar;
    private String sItemName;
    private Integer iPosition;
    private Handler mHandler;
    private String sMessage;
    private JSONObject jsonResponse;
    private GraphView graphView;
    private SearchableSpinner spinnerTimeWindow;
    private String[] sTime;
    private LineGraphSeries<DataPoint> series =  new LineGraphSeries<>();

    public DashboardItemFragment() {
        // Required empty public constructor
    }


    @Override
    public void onCreate(Bundle savedInstanceState) {
        super.onCreate(savedInstanceState);
        sItemName = getArguments().getString("ItemName");
        iPosition = getArguments().getInt("Position");
    }

    @Override
    public View onCreateView(LayoutInflater inflater, ViewGroup container,
                             Bundle savedInstanceState) {
        // Inflate the layout for this fragment
        return inflater.inflate(R.layout.fragment_dashboard_item, container, false);
    }

    @RequiresApi(api = Build.VERSION_CODES.O)
    @Override
    public void onViewCreated(@NonNull View view, @Nullable Bundle savedInstanceState) {
        super.onViewCreated(view, savedInstanceState);

        AppCompatDelegate.setDefaultNightMode(AppCompatDelegate.MODE_NIGHT_YES);

        graphView = view.findViewById(R.id.graphItem);
        spinnerTimeWindow = view.findViewById(R.id.spinnerSetTimeWindow);

        toolbar = view.findViewById(R.id.toolbarDashboardItem);
        toolbar.setNavigationIcon(getResources().getDrawable(R.drawable.ic_baseline_arrow_back_24));
        toolbar.setNavigationOnClickListener(new View.OnClickListener() {
            @Override
            public void onClick(View v) {
                getActivity().getSupportFragmentManager().popBackStack();
            }
        });

        if (sItemName.contains("!")){
            sItemName.replace("!","");
        }
        graphView.setTitle(sItemName);
        graphView.setTitleTextSize(35);
        series.setDrawDataPoints(true);
        series.setDataPointsRadius(5);
        series.setColor(getResources().getColor(R.color.ic_launcher_background));

        SharedPreferences userData = getActivity().getSharedPreferences("UserData", Context.MODE_PRIVATE);
        String sToken = userData.getString("Token",null);
        String sURL = userData.getString("URL", null);
        String sDashboardItemID = userData.getString("ItemIDs", null);
        String sDashboardItemUnit = userData.getString("ItemUnits", null);
        String sDashboardItemValueType = userData.getString("ValueType", null);
        String[] arrayIDs = sDashboardItemID.split(",");
        String[] arrayUnits = sDashboardItemUnit.split(",");
        String[] arrayValueType = sDashboardItemValueType.split(",");
        String sItemID = arrayIDs[iPosition];
        String sItemUnit = arrayUnits[iPosition];
        String sValueType = arrayValueType[iPosition];
        sItemUnit=sItemUnit.replaceAll("!","");

        graphView.getGridLabelRenderer().setVerticalAxisTitle(sItemUnit);

        spinnerTimeWindow.setOnItemSelectedListener(new AdapterView.OnItemSelectedListener() {
            @Override
            public void onItemSelected(AdapterView<?> parent, View view, int position, long id) {
                long presentTime = System.currentTimeMillis()/1000;
                long pastTime = SetTimeFrom(position);
                mHandler = new Handler(Looper.getMainLooper());
                OkHttpClient client = new OkHttpClient().newBuilder().build();
                MediaType mediaType = MediaType.parse("application/json");
                RequestBody body = RequestBody.create("{\n   \"jsonrpc\": \"2.0\",\n   " +
                                "\"method\": \"history.get\",\n   \"params\": {\n       \"output\": " +
                                "\"extend\",\n       \"history\": "+ sValueType +",\n       \"itemids\": \"" +
                                sItemID + "\",\n       \"time_from\": " +
                                pastTime + ",\n \"time_till\": " + presentTime + ",\n" +
                                "       \"sortfield\": \"clock\"," + "\n       \"sortorder\": \"ASC\"\n" +
                                "   },\n   \"id\": 1," + "\n   \"auth\": \"" +
                                sToken + "\"\n}\n"
                        , mediaType);
                Request request = new Request.Builder().url("http://"+sURL+"/zabbix/api_jsonrpc.php")
                        .method("POST", body).addHeader("Content-Type","application/json")
                        .build();
                client.newCall(request).enqueue(new Callback() {
                    @Override
                    public void onFailure(@NonNull Call call, @NonNull IOException e) {
                        sMessage = e.toString();
                        mHandler.post(new Runnable() {
                            @Override
                            public void run() {
                                Snackbar.make(getView(),sMessage,Snackbar.LENGTH_LONG).show();
                            }
                        });
                    }

                    @Override
                    public void onResponse(@NonNull Call call, @NonNull Response response) throws IOException {
                        sMessage = response.body().string();
                        mHandler.post(new Runnable() {
                            @Override
                            public void run() {
                                try {
                                    jsonResponse = new JSONObject(sMessage);
                                }catch (JSONException jsonException){
                                    Log.e("Parsing","Could not parse malformed JSON: \"" + sMessage + "\"");
                                }if(jsonResponse.has("result")){
                                    JSONArray jsonResult = jsonResponse.optJSONArray("result");
                                    if (jsonResult.length()>1){
                                        sTime = new String[jsonResult.length()];
                                        Float[] fValue = new Float[jsonResult.length()];
                                        DataPoint[] dataPoints= new DataPoint[jsonResult.length()];
                                        for (int i=0;i<jsonResult.length();i++){
                                            sTime[i] = jsonResult.optJSONObject(i).optString("clock");
                                            fValue[i] = Float.valueOf(jsonResult.optJSONObject(i).optString("value"));
                                            dataPoints[i]= new DataPoint(i,fValue[i]);
                                        }
                                        series.resetData(dataPoints);
                                        graphView.addSeries(series);
                                        graphView.getViewport().setXAxisBoundsManual(true);
                                        graphView.getViewport().setYAxisBoundsManual(true);
                                        graphView.getViewport().setMinY(getMinValue(fValue)*0.5);
                                        graphView.getViewport().setMaxY(getMaxValue(fValue)*1.5);
                                        graphView.getViewport().setMinX(0);
                                        graphView.getViewport().setMaxX(jsonResult.length()-1);
                                        graphView.onDataChanged(false,false);
                                        sTime=DateParser(sTime);
                                        StaticLabelsFormatter staticLabelsFormatter = new StaticLabelsFormatter(graphView);
                                        staticLabelsFormatter.setHorizontalLabels(sTime);
                                        graphView.getGridLabelRenderer().setLabelFormatter(staticLabelsFormatter);
                                        graphView.getGridLabelRenderer().setNumHorizontalLabels(3);
                                        graphView.getGridLabelRenderer().setLabelHorizontalHeight(50);
                                        graphView.getGridLabelRenderer().setHorizontalLabelsAngle(15);
                                        //graphView.getViewport().setScrollable(true);
                                        graphView.getViewport().setScalable(true);

                                        series.setOnDataPointTapListener(new OnDataPointTapListener() {
                                            @Override
                                            public void onTap(Series series, DataPointInterface dataPoint) {
                                                String msg = dataPoint.getY()+" at "+sTime[(int)dataPoint.getX()];
                                                Toast toast = Toast.makeText(getActivity(),msg,Toast.LENGTH_SHORT);
                                                toast.setGravity(Gravity.CENTER,0,0);
                                                toast.show();
                                            }
                                        });
                                    }else{
                                        Snackbar.make(getView(),"No hay datos para mostrar",Snackbar.LENGTH_LONG)
                                                .show();
                                    }
                                }
                            }
                        });
                    }
                });
            }

            @Override
            public void onNothingSelected(AdapterView<?> parent) {

            }
        });
    }

    private Float getMaxValue(Float[] array){
        List<Float> list = new ArrayList<Float>();
        for (int i=0;i<array.length;i++){
            list.add(array[i]);
        }
        return Collections.max(list);
    }

    private Float getMinValue(Float[] array){
        List<Float> list = new ArrayList<Float>();
        for (int i=0;i<array.length;i++){
            list.add(array[i]);
        }
        return Collections.min(list);
    }

    String[] DateParser(String[] str){
        for (int i=0;i<str.length;i++){
            long dl = Long.valueOf(str[i])*1000; //Debe estar en milisegundos
            Date dd = new java.util.Date(dl);
            str[i] = new SimpleDateFormat("HH:mm:ss").format(dd).toUpperCase();
        }
        return str;
    }

    long SetTimeFrom(int pos){
        long pastTime=0;
        Calendar cTimeAgo = Calendar.getInstance();
        switch (pos){
            case 0:
                cTimeAgo.add(Calendar.MINUTE, -5);
                pastTime = cTimeAgo.getTimeInMillis();
                break;
            case 1:
                cTimeAgo.add(Calendar.MINUTE, -10);
                pastTime = cTimeAgo.getTimeInMillis();
                break;
            case 2:
                cTimeAgo.add(Calendar.MINUTE, -15);
                pastTime = cTimeAgo.getTimeInMillis();
                break;
            case 3:
                cTimeAgo.add(Calendar.MINUTE, -30);
                pastTime = cTimeAgo.getTimeInMillis();
                break;
            case 4:
                cTimeAgo.add(Calendar.MINUTE, -60);
                pastTime = cTimeAgo.getTimeInMillis();
                break;
            case 5:
                cTimeAgo.add(Calendar.HOUR, -2);
                pastTime = cTimeAgo.getTimeInMillis();
                break;
            case 6:
                cTimeAgo.add(Calendar.HOUR, -3);
                pastTime = cTimeAgo.getTimeInMillis();
                break;
            case 7:
                cTimeAgo.add(Calendar.HOUR, -6);
                pastTime = cTimeAgo.getTimeInMillis();
                break;
        }
        return pastTime/1000;
    }
}
