alexisvieiro/ProyectoFinal/(commit log)

2021-07-10 Commit inicial
    [434121043836 (rev1).stp, 5040771891.stp, BAT54.step, CD32_inductor.step, Connector_1Port_RJ45_Magjack_10-100Base-T_AutoMDIX_Wurth_Electronics-7499010441.stp, DO-214AA_SMB.step, DO-214AC_SMA.step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]
2021-07-10 Ahora la temperatura es redondeada al entero mas cercano, en vez del entero menor.
2021-07-16 Delete farfield_12g.ffs
    Vuelta para atrás
2021-08-13 mib2zabbix actualizado
    Se actualizó mib2zabbix para evitar problemas con la key en los traps generados.
2021-08-13 MIBS de Fortigate agregados de nuevo
2021-08-16 Archivos de placa actualizados.
    Se eliminaron archivos innecesarios de software y archivos de kicad actualizados.
    [434121043836 (rev1).stp, 5040771891.stp, BAT54.step, CD32_inductor.step, Connector_1Port_RJ45_Magjack_10-100Base-T_AutoMDIX_Wurth_Electronics-7499010441.stp, DO-214AA_SMB.step, DO-214AC_SMA.step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]
2021-08-17 Proyecto de kicad actualizado.
    Se eliminó completamente la sección de la MicroSD
    [ESP32-GATEWAY_Rev_F.kicad_pcb, ESP32-GATEWAY_Rev_F.sch]
2021-08-18 Proyecto de kicad actualizado
    Se retiró la parte del programador USB y otras menores asociadas a esta.
    [ESP32-GATEWAY_Rev_F.kicad_pcb, ESP32-GATEWAY_Rev_F.sch]
2021-08-21 Proyecto de Kicad actualizado
    Fuente corregida. Programador agregado. Cambios menores.
    [ESP32-GATEWAY_Rev_F.kicad_pcb, ESP32-GATEWAY_Rev_F.sch]
2021-08-22 Proyecto de kicad actualizado.
    Se agregaron los conectores adecuados y se rutearon los gpio para estos. Queda pendiente ubicarlos correctamente para evitar el solapamiento de estos. Se acomodaron algunas resistencias y se eliminaron pistas viejas innecesarias.
    [10104110-0001LF.stp, 2pin-molex.stp, ESP32-GATEWAY_Rev_F.kicad_pcb, ESP32-GATEWAY_Rev_F.sch]
2021-08-23 Proyecto en kicad actualizado
    Se modificó la posición de la pinera para programar la placa. Recolocaron los conectores de los sensores y se agregaron sus resistencias mas el modelo 3D de todo esto.
    [ESP32-GATEWAY_Rev_F.kicad_pcb, ESP32-GATEWAY_Rev_F.sch]
2021-08-24 Proyecto en kicad actualizado
    Push button agregado, se acomodaron los sensores y se agregó un capacitor a la salida de la fuente
    [ESP32-GATEWAY_Rev_F.kicad_pcb, ESP32-GATEWAY_Rev_F.sch]
2021-08-25 Proyecto en kicad actualizado
    Se agregaron logos propios. Y se corrigieron otras serigrafias.
    [ESP32-GATEWAY_Rev_F.kicad_pcb]
2021-08-27 Carga de la app
2021-08-27 Carga de la app android
2021-08-27 Placa kicad actualizada
    [ESP32-GATEWAY_Rev_F.kicad_pcb, ESP32-GATEWAY_Rev_F.sch]
2021-08-27 Placa de kicad actualizada
    Se agregaron los optoacopladores en los sensores de puerta, y se movieron los logos en la silkscreen de Ericnet y JLCPCB para la capa de atrás.
    [ESP32-GATEWAY_Rev_F.kicad_pcb]
2021-08-27 Proyecto en kicad actualizado
    Se modificó el footprint del Inductor de la fuente
    [ESP32-GATEWAY_Rev_F.kicad_pcb]
2021-08-27 Proyecto en kicad actualizado
    Esquemático actualizado
    [ESP32-GATEWAY_Rev_F.sch]
2021-08-28 Se agregaron 2 sensores de puerta y se sacó uno de temperatura
    [ESP32-GATEWAY_Rev_F.kicad_pcb, ESP32-GATEWAY_Rev_F.sch]
2021-09-01 codigo de esp32 se le agrego el oid de freeheap
2021-09-04 Codigo de ESP32 actualizado
2021-09-10 Gerbers + ESP32 https server
    Se agregaron gerbers y cambios finales de la placa. Se agrego un servidor https al codigo para el esp32
    [ESP32-GATEWAY_Rev_F-B_Adhes.gbr, ESP32-GATEWAY_Rev_F-B_CrtYd.gbr, ESP32-GATEWAY_Rev_F-B_Cu.gbr, ESP32-GATEWAY_Rev_F-B_Fab.gbr, ESP32-GATEWAY_Rev_F-B_Mask.gbr, ESP32-GATEWAY_Rev_F-B_Paste.gbr, ESP32-GATEWAY_Rev_F-B_SilkS.gbr, ESP32-GATEWAY_Rev_F-Cmts_User.gbr]
2021-10-09 Agregado del menú de items al dashboard
2021-10-13 Uso de nueva librería de gráficas
2021-10-20 Cambios en el servidor
2021-10-21 Cambios en el server. Muestra correctamente la IP actualmente configurada
    [ESP32-Code.ino]
2021-10-22 Agrego de ventanas de tiempo
2021-10-27 Cambio de card en el menú de hosts
2021-10-27 Cambios en el https server para configurar la ip del hub snmp
2021-10-31 Eliminado proyecto en arduino
2021-10-31 Reordenado carpetas de esp32 hub
    [10104110-0001LF.stp, 2pin-molex.stp, 434121043836 (rev1).stp, 5040771891.stp, BAT54.step, CD32_inductor.step, DO-214AA_SMB.step, DO-214AC_SMA.step]
2021-11-05 Agregado de lista completa de hosts y items respectivos
2021-11-17 Respuestas del ESP32 a oids estandar actualizado. Se agregaron oids para la consulta del estado de las puertas.
2021-11-19 App para notificiaciones modelo agregada
2021-11-21 Proyecto de PCB en Kicad actualizados
    -Se modifico el nombre del proyecto en kicad.
    -Se generó el BOM actualizado.
    -Se generó el pdf del esquematico actualizado.
    -Se eliminaron archivos viejos innecesarios
    [ESP32-GATEWAY_Rev_F-BOM.ods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]
2021-11-21 Nombres de archivos de esquematico y bom actualizados.
    [HUB-SNMP_BOM.csv]
2021-11-24 Finalizada la búsqueda de hosts
2021-12-03 Agregada la muestra de problemas y las notificaciones
    [ProblemFragment.java]
2021-12-14 cambios de pines en los sensores de puerta
2021-12-15 Carcasa stl actualizada
    [Carcasa-CarcasaBase de la Carcasa.stl, Carcasa-CarcasaTapa de la Carcasa.stl, Carcasa.FCStd]
2022-03-19 Layouts Subidos
    [HUB-SNMP-NPTH.drl, HUB-SNMP-PTH.drl]
2022-03-19 Subido test de aceptación
2022-03-20 Versión final de la app
2022-03-20 Nombres de los Informes cambiados
2022-03-22 Cambio nombres de carpetas
    [10104110-0001LF.stp, 2pin-molex.stp, 434121043836 (rev1).stp, 5040771891.stp, BAT54.step, CD32_inductor.step, Carcasa-CarcasaBase de la Carcasa.stl, Carcasa-CarcasaTapa de la Carcasa.stl]
2023-11-21 notificaciones.py creada
    se agrego script para mandar notificaciones de android via zabbix
2024-01-09 Cambios en libreria Ethernet y Template ESP32 SNMP Agregado
2024-02-12 eliminacion de comentarios
2024-02-15 tesina actualizada - proyecto kicad actualizado
